jinxiao123580-hub/balance-car/hardware/pcb/README.md

# PCB资料状态说明

| 属性 | 内容 |
| --- | --- |
| 文档编号 | PH-PCB |
| 更新日期 | 2026-10-28，Asia/Shanghai；时分未记录 |

## 已有资料

v2026-09-23目录保留Board1与PCB1的.epro2包。两个源包分别保留，未因名称相近判定为重复。

## 待完成检查

库引用、板层、DRC、电源回流及生产导出未在本次归集验证。生产文件与BOM分别记录于相邻目录。
