jinxiao123580-hub/balance-car/hardware/schematic/README.md

# 原理图资料状态说明

| 属性 | 内容 |
| --- | --- |
| 文档编号 | PH-SCHEMATIC |
| 更新日期 | 2026-10-28，Asia/Shanghai；时分未记录 |

## 已有资料

v2026-09-23目录包含Schematic1的嘉立创.epro2源包，extracted保留原有解包文件及版本信息。源文件按原件校验。

## 待完成检查

尚未在EDA中核对符号、网络、库引用及导出PDF。当前源包不得等同于电气审查已经通过。
