jinxiao123580-hub/balance-car/mechanical/cad/README.md

# 机械设计源文件状态说明

| 属性 | 内容 |
| --- | --- |
| 文档编号 | PH-MECHANICAL-CAD |
| 更新日期 | 2026-10-28，Asia/Shanghai；时分未记录 |

## 已有资料

已归集STM32_Balance_V2.SLDASM、两份零件电机-主体连接.SLDPRT与载物台.SLDPRT。原件指纹校验通过。

上述原生CAD文件仅保留在本机。发布前需使用原软件检查内部作者、个人路径及其他元数据，本次由Git忽略；公开几何文件见[STL目录](../printable/)。

## 完整性限制

未使用SolidWorks打开验证外部引用，不能认定装配依赖完整。如存在缺件，需通过Pack and Go形成自包含包。STEP等通用格式尚未归集。
