jinxiao123580-hub/balance-car/docs/design/ros-layered-options-latex/README.md

# 平衡车 ROS 分层建设与成本选型研究

本文以论文式技术方案比较三个建设层次：保留现有 STM32、增加 ESP32、增加 Linux 车载板卡。包括摘要、需求与约束、架构设计、功能矩阵、预算、标定公式、实施验收和参考文献。费用为新增硬件预算估算，不是实时采购报价；内容不构成已完成的性能实验。

主文件：main.tex。

推荐使用 XeLaTeX，运行两遍以更新交叉引用和参考文献编号。使用 ctexart；当前 Windows 预览按相对路径加载 fonts/ 下的本机仿宋、黑体与楷体文件。字体仅供本机使用，已排除进入 Git；转移工程前应按目标环境重新配置合法可用的中文字体。项目可在 Codex 内置 LaTeX 编辑器中直接打开并预览 PDF。

工程位置：仓库内 `docs/design/ros-layered-options-latex/`。

对应总库入口与旧 PlatformIO 目录指向同一工程，不应再复制一份进行维护。

编译检查：2026-10-29，Codex 内置 LaTeX 编译器返回 success。正文为论文式方案分析，引用编号与表格、公式交叉引用已检查，预算分配合计2000元。首次运行可能需要初始化中文字体及TeX组件。
