jinxiao123580-hub/balance-car/docs/system-overview.md

# 系统设计说明

| 属性 | 内容 |
| --- | --- |
| 文档编号 | PH-SYSTEM-CURRENT |
| 更新日期 | 2026-10-28，Asia/Shanghai |
| 适用版本 | software/firmware中的当前归集版本 |

## 1. 系统组成

STM32F407ZG完成姿态处理、编码器采样和运动控制，BMI270提供惯性数据，步进驱动器接收STEP/DIR。电脑端通过BLE完成参数设置、曲线显示及CSV记录。

当前固件使用TMC_STANDALONE_STEP_DIR=1，不依赖UART寄存器配置才能启动。驱动电流、细分和斩波模式由实际载板硬件配置决定；两侧最终板件型号及拨码电平尚需在装配清单中统一确认。

## 2. 控制结构

```mermaid
flowchart LR
    ENC[编码器位置与速度] --> POS[位置P环]
    POS --> VREF[受限目标速度]
    ENC --> SPEED[速度PI环]
    VREF --> SPEED
    SPEED --> ANGLE[目标倾角修正]
    OFFSET[机械平衡角 O] --> TARGET[目标倾角]
    ANGLE --> TARGET
    IMU[BMI270姿态与角速度] --> PD[直立PD]
    TARGET --> PD
    PD --> DELTA[频率增量与限幅]
    DELTA --> INTEGRATE[积分生成STEP频率]
    INTEGRATE --> STEP[TIM2/TIM5边沿调度]
    STEP --> MOTOR[步进驱动与电机]
    MOTOR --> ENC
```

主循环设计周期2.5ms；速度及位置目标计算约100Hz。直立PD输出经R换算为频率增量，每10ms形成端点，再分成四个子步执行。L/S/B/H分别限制频率、常规增量和高速同向加速增量。

## 3. 引脚与接口

| 功能 | 引脚 | 当前软件实现 |
| --- | --- | --- |
| Motor1 STEP / DIR | PA6 / PA7 | TIM2中断调度PA6 GPIO，方向极性motor1Invert=false |
| Motor2 STEP / DIR | PA8 / PB0 | TIM5中断调度PA8 GPIO，方向极性motor2Invert=true |
| BMI270 SCL / SDA | PB8 / PB9 | I2C |
| 编码器1 A / B | PA0 / PA1 | 中断计数 |
| 编码器2 A / B | PB6 / PB7 | 中断计数及可信通道选路 |
| BLE串口 TX / RX | PB10 / PB11 | USART3 |

物理引脚不变，但STEP已不采用旧TIM3/TIM1 PWM机制。软件极性不替代对实际电机接线和轮向的确认。

## 4. 参数与位置原点

当前默认配置见[参数表](parameters.md)。位置环启用时捕获当时编码器位置，面板“当前位置设为回位点”重新指定原点。

位置与速度按可信编码器选路：双路平均或单路计数。位置采用增量累计，来源切换不引入累计位置跳变；点动时来源改变会取消任务。编码器分辨率、轮径和精确回原点仍待实测。前后遥控采用[固定倾角按住控制](turning.md)，相对O ±2°平滑建立和退出，期间暂停速度/驻车角度修正并清除速度I。回零后1秒渐入原速度环；驻车目标在整个移动、回零与恢复期间跟随当前位置，并清除旧的位置速度斜坡，恢复结束才锁定新驻车点，累计位置连续。此版尚未烧录实测。

## 5. 验证边界

当前源码独立编译、主机逻辑回归及面板离线界面检查通过；设计脉宽、实际ISR抖动、当前默认参数下的位置保持与所有工况稳定性尚无统一验证报告。历史试验不直接替代当前版本验证。
