jinxiao123580-hub/balance-car/history/reports/conflicts.md

# 技术勘误与遗留问题报告

| 属性 | 内容 |
| --- | --- |
| 报告编号 | PH-ISSUES-20261028 |
| 更新日期 | 2026-10-28，Asia/Shanghai；时分未记录 |
| 来源 | [证据索引](sources.md) |

历史误判与当前技术结论分列如下。争议事项未因报告规范化而视为解决。

| 编号 | 来源中的说法 | 合并后的处理 |
| --- | --- | --- |
| C01 | S2 写本车没有 A4988 / TMC 实机记录，S1 记录了这些阶段 | S2 的范围限于早期阶段记录，缺少记录不代表整个项目没使用。A4988 阶段先记为 S1 对 PPT 的转述；TMC 迁移由 S3/S5 补充。 |
| C02 | S1 称 10 月 MKS 出厂即 SC、无需焊接；S3 中现场称短接空焊盘，将 SPREAD 接 VIO，声音变大 | 两种历史叙述都保留。可能涉及不同板件、时间或识别错误，现有证据不能选定一个。不可写成所有 MKS V2.0 出厂默认 SC；不可据声音独立证明模式。 |
| C03 | S1 当前框图仍写 TIM3/PA6、TIM1/PA8 | 旧 PWM 阶段成立；S6 当前源码是 TIM2/TIM5 中断驱动 GPIO PA6/PA8。引脚相同不代表定时器或输出机制相同。 |
| C04 | S2 等记录把 CSV 中 m1Hz/m2Hz 非零说成定时器确实输出正确 STEP | CSV 证明软件命令非零；只有 GPIO 波形或回环计数能验证实际输出。无修复前后波形，不能把这一点写成实测事实。 |
| C05 | S4/S1 将三细分比较写成“已否证增量扭矩不足” | 比较中 O、K、L/S 和编码器状态同时变化，只能说明换细分没有在那些组合中消除现象。不能严格否证所有扭矩或衰减假设。历史锁定率未经本轮重算，不作标准化性能指标。 |
| C06 | S1 转述 A4988 “EN 拉低导致锁死”，并推断应把 EN 拉高使能 | A4988 ENABLE 低有效：高电平关闭输出，低电平允许输出；SLEEP 低电平休眠。抱持不转不等于 EN 低造成故障。不能按原推断接线。见下方厂商手册。 |
| C07 | 早期记录给出不同 VREF 换算，部分文字混淆公式与例子 | 本轮不沿用统一换算。驱动型号、采样电阻和电流定义必须先确定；BTT 的 rms_current(1200) 是配置请求，不是实测相电流。 |
| C08 | S1 一处写 TMC2208 无 UART | 不沿用该选型说法；是否有芯片接口和具体载板是否引出接口需分开核对，本项目无需靠该判断解释结果。 |
| C09 | S1 将 10 月后阶段写成缺少稳定运行记录 | S3 补有烧录成功、现场稳定反馈和 10-20 分段分析；可以描述这些观测，但仍没有统一条件的长期失步率、恢复时间和台架对照。 |
| C10 | S1 将 enc2 有计数进一步解释为接线故障被修好 | 有计数说明该时段通道有活动；不能证明根因、永久恢复或信号正确。没有已记录的维修动作。 |
| C11 | S1/S4 强调衰减模式；S3 强调 STEP 调度与换向、阻塞修复 | 分别是阶段性假设和软件发现。模式、代码、限幅和硬件都发生过变化，不能把成功单独归到 SC 或单个软件缺陷。 |
| C12 | S1 从 PPT 文件时间推断 A4988→DRV8825 发生在 8 月 16～17 日 | 文件修改时间不能保证内容反映当日硬件。该窗口仅作原作者推断保留，合并时间线将确切更换时间标为未知。 |
| C13 | S1/S3 或注释混写“位置环 400Hz” | 当前位置测量在主循环约 400Hz 更新；位置 P 生成目标速度是在 updateOuterLoop 中约 100Hz。应区分测量周期和控制计算周期。 |
| C14 | S3 指出单编码器位置尺度问题，并提出修复 | 这是发现和建议，尚未完成该项修复。S6 位置仍固定平均两路累计计数，速度则按信任门选路。不能把“计划修正”写成“已修正”。 |
| C15 | 早期叙述说“角度误差直接给 STEP 只适用于直流电机” | 这是当时的设计讨论，不是普遍定理。STEP 频率对应速度，直流电机通常用 PWM/电流指令；本车改用 PD→速度增量→积分频率结构。不能仅凭此判定所有直接速度控制结构无效。 |
| C16 | 部分阶段报告把 OpenOCD stderr / exit 1 统一视作烧录成功 | 只按当次 Programming、Verified OK、Resetting 等明确输出判断，不能忽略真正的 init/open failed 或校验失败。 |

## 模式、电平与引脚判定

TMC2209 独立模式可由 SPREAD 配置斩波方式；寄存器配置还需考虑 GCONF、OTP 等状态。对 VIO=3.3V 的具体模块，先确认目标网络和允许电平，不能仅凭 R9 字样、空焊盘或旧标注图就指导短接。S1/S3 中对焊盘、芯片脚号、+5V/VIO 的说法不一致，本整理不发布焊接操作图。

S3 中曾有 未经实物核验的焊盘标注被撤回，不作为接线依据。现场“已将 SPREAD 接到 VIO”的反馈可归档，但未补测量照片或寄存器读回。

## 参考依据

- [Allegro A4988 数据手册（Pololu 托管），Enable Input / Sleep Mode，印刷页 10](https://www.pololu.com/file/0J450/A4988.pdf)：ENABLE 高关闭、低允许输出；SLEEP 低休眠。
- [ADI TMC2209 数据手册 Rev.1.09](https://www.analog.com/media/en/technical-documentation/data-sheets/TMC2209_datasheet_rev1.09.pdf)：核对 SPREAD、VCC_IO 与 GCONF；厂商芯片资料不能单独证明手中载板的焊接状态。
- [MKS 官方 V2.0 原理图](https://github.com/makerbase-mks/MKS-StepStick-Driver/blob/master/MKS%20TMC2209/MKS%20TMC2209%20V2.0_001/MKS%20TMC2209%20V2.0_001%20SCH.pdf)：载板连接参考，需和实物核对。

以上资料用于纠正一般电气逻辑，不替代本车测试。原始观点可由中转区备份追溯；正式结论采用本页及阶段报告的限定口径。
