jinxiao123580-hub/balance-car/history/reports/sources.md

# 证据与资料索引

| 属性 | 内容 |
| --- | --- |
| 文档编号 | PH-EVIDENCE-20261028 |
| 更新日期 | 2026-10-28，Asia/Shanghai；时分未记录 |
| 覆盖范围 | 工程源文件、阶段报告、实验数据与硬件资料 |
| 状态 | 已归集主要项目文件；部分测量与原始版本记录缺失 |

## 1. 来源编号

| 编号 | 资料 | 时间范围与适用边界 |
| --- | --- | --- |
| S1 | [开发阶段总结](records/report_development_20260520_20261024.md) | 汇报前史至2026-10-24；部分事件由文件时间或后期记录重建 |
| S2 | [控制与遥测联调报告](records/report_control_20260917_20260918.md) | 主要为2026-09-17～18；未覆盖后续硬件不代表项目未采用 |
| S3 | [驱动集成与验证进展报告](records/report_integration_20260928_20261028.md) | 2026-09-28～10-28；实施、烧录及实机反馈分别记录 |
| S4 | [换向异常阶段试验报告](records/report_reversal_20260923.md) | 截至2026-09-23 20:44；多变量试验不是唯一根因证明 |
| S5 | [混配驱动阶段验证报告](records/report_hybrid_20260928.md) | 截至2026-09-28 19:25；UART配置状态未读回 |
| S6 | [主固件](../../software/firmware/src/main.cpp)、[构建配置](../../software/firmware/platformio.ini) | 归集版本；新路径构建及主机回归通过，不代表所有工况实机验证 |
| S7 | [蓝牙面板](../../software/ble-panel/ble_tune_panel.py) | 默认22项与固件匹配；路径和本机设备地址配置已适配 |

S1～S5为规范化报告。改写前文本及初始来源原件保存在仓库外中转区，原件指纹用于追溯。当前报告不冒充未经编辑的原始实验转储。

## 2. 原始来源指纹

| 来源 | 原件SHA-256 |
| --- | --- |
| S1 | B67D247555B5D59C8087419D47E7CDABA4F3C69212C3829FC85396E95BCA6D3C |
| S2 | 790A30408AFC9967DBA137BB1D214066B34E4FD7352A60D1D3B7330C8160B219 |
| S4 | 10E0C06B553E8ED2121E56D124CAD92389389999A728C11C4DF0E66E347F7847 |
| S5 | 8941DCC59E673025D8CE9FCBB16FC89F8EB7A54C978620962607403AC39B76B7 |
| S6主程序 | 7D155CB84F41D116D17F3692096D2B28EC13DE413B4093BB4CB900DBE99AA22B |
| S7迁移前面板 | 825EED78BC7673F46502F4BC0AC83F40D4C445596CD011653F41897EC8C690BC |

指纹不证明内容正确，也不等于规范化副本的当前指纹。面板迁移后已调整数据路径和设备地址读取方式。

## 3. 实验数据

94份日期命名调参CSV及其他诊断数据位于[raw目录](../data/raw/)。日期来自文件名，ms表示MCU上电时间；参数标签由面板写入，需与设备回显及下发记录核对。

| 文件 | 用途 | 分析状态 |
| --- | --- | --- |
| ble_tune_log_20260917_165009_185_p11420.csv | 高频命令与反馈不一致 | 有历史分析；尚无同步STEP波形 |
| ble_tune_log_20260917_171045_688_p11420.csv | 失败录制 | 仅重连标记，不作运动证据 |
| ble_tune_log_20260917_203534_858_p11420.csv | 失败录制 | 仅表头，不作运动证据 |
| ble_tune_log_20260923_195736_949_p17656.csv | 换向相关异常 | 历史统计待统一算法复核 |
| ble_tune_log_20260923_203020_049_p24520.csv | 1/8试验组合 | 多变量条件，不作单因素比较 |
| ble_tune_log_20260928_173505_691_p32248.csv | 混配阶段 | SC未读回 |
| ble_tune_log_20261015_204349_410_p32652.csv | 不跟随片段 | 已有分段分析，无物理输出测量 |
| ble_tune_log_20261020_095502_292_p23136.csv | 未干预末四分钟 | 已有姿态与漂移统计 |
| ble_tune_log_20261020_104252_893_p44156.csv | 位置环开启后的末四分钟 | 已有目标速度与回位分析 |
| ble_tune_log_20261022_212411_029_p28960.csv | 后期长记录、编码器2活动 | 已归集，未重新统计锁定率 |
| ble_tune_log_20261024_200643_992_p29636.csv | 后期长记录和O调整 | 已归集，未重新统计锁定率 |

m1Hz/m2Hz为软件命令，不是频率计或示波器实测结果。失败录制、人工操作区间与自主运行区间分别判定。

## 4. 硬件与机械资料

| 资料 | 仓库位置 | 当前核验状态 |
| --- | --- | --- |
| Board1、PCB1的.epro2源包 | hardware/pcb/v2026-09-23/ | 原件指纹校验；尚未完成EDA规则及库检查 |
| Schematic1的.epro2及已有解包内容 | hardware/schematic/ | 同上 |
| STM32_Balance_V2.SLDASM及两份.SLDPRT | mechanical/cad/ | 原件校验；装配外部引用待核对 |
| 两份STL | mechanical/printable/ | 原件校验；打印参数待补充 |
| VID_20260811_103124.mp4 | history/media/video/ | 已归集；不由文件名推导当前版本性能 |
| 平衡车系统汇报.pptx | history/presentations/ | 早期项目资料；未逐页完成公开审查 |
| 多项目组会汇报相关页 | 外部共享资料，未整份纳入仓库 | 历史报告引用第183～186页，未重新解析 |
| 厂商PDF | docs/references/vendor/，默认不入Git | 官方链接见参考资料目录，需和实物核对 |

## 5. 缺失证据与补充计划

- 修复前后STEP/DIR及相电流波形，ISR延迟和抖动。
- 相同硬件、参数与动作下的SC/stealthChop及输出机制单变量对照。
- 两轮载板标识、限流、细分、供电及焊位的统一登记。
- TMC成功读回帧，编码器2维修与持续可靠性记录。
- 位置尺度修正、原点保持与速度积分整定结果。
- 每次实施时间、代码版本及烧录记录的完整对应关系。

资料缺口作为项目状态的一部分保留，不以推断补齐。
