jinxiao123580-hub/balance-car/history/reports/records/report_integration_20260928_20261028.md

# 驱动集成与验证进展报告

| 属性 | 内容 |
| --- | --- |
| 报告编号 | PH-INTEGRATION-20261028 |
| 事件范围 | 2026-09-28～2026-10-28；部分事项只保留相对顺序 |
| 编制日期 | 2026-10-28，Asia/Shanghai；时分未记录 |
| 依据 | 操作记录、实机反馈、代码、构建/烧录输出及已有CSV分析 |
| 结论口径 | 实施、主机验证和实机观测分别陈述 |

## [9 月 28 日阶段及之后，部分事件日期未知] UART、载板和电平排查

- 现场反馈 TMC UART 连续失败；不同阶段日志有 rx=0、PA9 低电平、接入后约 1.06V、断开后 3.3V。
- 现场报告早期开发板稳压部分损坏、更换板子；后续给出 VIO≈3.3V、VM≈11～12V 的测量。不同测量属于不同硬件状态，不能当成一个连续恒定条件。
- 写入专用固件出现 bytes=192、PA9≈3.28V，只能确认发送路径和直流电平，不能确认 TMC 收到帧或寄存器生效。
- 读回测试仍出现 address=-1、rx=0；没有 version、IFCNT、GCONF 的成功读回。
- 单向转问题经现场重新交换测试，故障随某块 TMC 载板迁移；与 S5 阶段记录一致。不能从 UART 失败单独推断相同故障。

## [MKS 阶段，具体日期未完全定位] 硬件配置 spreadCycle

- 现场说明将 MKS 空焊盘短接，使 SPREAD 接到 VIO；改完声音变大。
- 现场随后仍报告锁死，要求检查软件。
- S1 另有“出厂即 SC、无需改焊”的描述，二者尚未消解；两类记录均不推广至所有同型号板件。
- 独立 STEP/DIR 固件不通过 UART 请求模式。现场反馈与配置条件支持硬件模式选择的判断，但没有寄存器或电流波形证据。

## [2026-10-14～15 阶段；精确时刻未知] STEP/DIR 与方向配置

- 主固件设置 TMC_STANDALONE_STEP_DIR=1，跳过 UART 初始化阻塞和读回流程；继续由 STEP/DIR 控制电机。
- 工程记录报告只翻转后轮 motor2Invert，保持 speedLoopDirection=-1；归集版本源码为 motor1Invert=false、motor2Invert=true。
- 现场之后仍反馈方向反了，不能仅凭代码或烧录成功判定物理方向已完全验证。后来稳定运行反馈是后续组合状态，不用于补写当时的单独测试结果。

## [2026-10-15] 锁死日志与软件审查

- 证据文件：ble_tune_log_20261015_204349_410_p32652.csv。
- 已有分段分析记录在 MCU 129.189～129.939s，命令由 1210Hz 升到 3500Hz，enc1 保持 -3039；约 130.189s enc1 再变化。
- 这支持“命令与编码器运动不一致”，不证明实际 STEP 波形，也不排除编码器漏计。
- 代码审查发现：正→0→负可漏判换向；长参数回显直接串口打印可能阻塞；固定时间基准在长延迟后会补跑积分；旧 PWM 运行时参数预装载可能造成低频更新滞后；停机/零指令行为不明确。
- 其中低频预装载与故障之间没有波形对照，仅为代码机制上的嫌疑，不能写成已实测根因。

## [2026-10-15] 实施修复，编译及主机回归

- STEP 改用 TIM2/TIM5 的定时器中断调度 PA6/PA8 GPIO 边沿；固定高脉宽设计为 4µs，保持 DIR 建立间隔。硬件实际脉宽仍待测。
- 保留最后非零方向，在 2.5ms 子周期预测跨零并应用软保护；清除控制状态时重置换向状态。
- 零指令停止发步并拉低 STEP；非法命令停止该路。
- 蓝牙回复用 QueuedBtReply 入队，控制超时重同步，不集中补跑；增加边沿计数和耗时诊断。
- 验证记录编译成功；test/run_motion_regressions.py 的主机模拟检查通过。主机寄存器模拟不覆盖真实 ISR 延迟、并发与物理输出波形。
- 阶段记录明确“暂未烧录”；不能把编译日期当作首次运行日期。

## [2026-10-20] 修复版烧录及现场稳定反馈

- 验证输出包含 Programming Finished、Verified OK、Resetting Target、SUCCESS。
- 现场随后反馈稳定、仍有少量漂移、离开原位后回不去。
- 同时较早失败组合与此时参数不同，例如 S=400→100、L=3500→1750。模式、参数和代码共同变化，未完成单变量归因。

## [2026-10-20，09:55 录制] 无人干涉最后四分钟，位置环关闭

- 文件：ble_tune_log_20261020_095502_292_p23136.csv。
- 按现场澄清，只评估 MCU 149.623～389.623s，961 条记录。此前 O 调整为人工调参，不当作异常跳变。
- 固定参数包括 P=1000、D=100、O=10、K=-0.02、I=0、X=0、Y=0。
- 已有分段分析：平均 pitch≈9.968°，956/961（约99.5%）采样在9～11°；fallStopCount未增加。该采样比例不等于全带宽姿态误差或长期可靠性。
- 位置显示从-2627.5到-1800；回位目标速度全程0。不能期待关闭的位置环返回原点。
- 速度按可信编码器选路，位置仍固定平均两路；enc2接近不变时位置尺度约减半。发现了该问题，但未实施修复。

## [2026-10-20，10:42 录制] 位置环开启，但仍漂移

- 文件：ble_tune_log_20261020_104252_893_p44156.csv。
- 最后四分钟 MCU 164.333～404.333s，961条；O=12、K=-0.02、I=0、X=0.5、Y=1、M=30。
- 已有分段分析：pitch范围11.19～12.63°，位置从-8到-118；866/961（约90%）样本的回位目标速度已到+1；修正角未撞到N=2°。
- 判断：位置环已发回位要求，不能再说“未开启”。仅增大X在输出已受Y限制时不会增加最大回位要求。速度跟踪、符号和慢偏置仍需验证。
- 曾提出K=-0.05评估方案，但尚未取得该方案的实测确认；不作为稳定基线。
- I=0关闭速度积分。J=2、Y=1时，静止附近小回位速度误差可能达不到积分门槛；不是已实施的新积分策略。

## [2026-10-22] 现场指定截图参数，设为固件默认并烧录

```text
P=1000 D=100 O=4 Z=0
L=1750 S=100 B=1000 H=40 R=0.1
K=-0.02 I=0 N=2 W=50 J=2 E=0
X=5 Y=1 M=0 F=5 G=10 T=0 U=0
```

- 实际修改默认值O、X、Y、M及初始targetBalanceAngle，其余匹配截图。
- 验证输出Programming Finished、Verified OK、Resetting Target、SUCCESS。烧录成功不自动证明这组参数可精确回原点。
- 独立位置I方案仅讨论过，没有实现；速度环仍通过目标角修正进入直立环。

## [2026-10-23] 蓝牙面板默认值同步

- 面板PARAMS修改O=4、X=5、Y=1、M=0。
- 对22项默认参数做AST/语法检查并与固件声明比对，通过。
- 已打开面板需重启载入新默认；默认值、待发输入和车端实际状态仍需区分。

## [2026-10-27] 展示目录建立

- 建立hardware、software、mechanical、docs分类和README、.gitignore。
- 当时未复制整套固件、硬件文件，也未创建或上传GitHub仓库。
- 阶段分析认为软件修复、SC配置与较温和参数共同伴随改善；缺少单变量对照，不作单一根因判定。

## [2026-10-28] 本次合并

- 完成阶段资料S1/S2/S4/S5核对，确认当前TIM2/TIM5输出实现及默认参数，并清点94份CSV及硬件材料。
- 完成工程归集、新路径编译、主机回归及面板界面检查；未重新烧录或永久删除。
- 本报告为阶段资料汇编，不替代原始波形、逐次代码版本和设备配置确认。来源及技术勘误分别见[证据索引](../sources.md)和[技术勘误](../conflicts.md)。
