jinxiao123580-hub/balance-car/docs/publishing.md

# 公开发布范围

日期：2026-10-28，Asia/Shanghai。

本次公开固件、面板、分析工具、原理图与PCB源包、STL、规范化技术报告和历史调参数据。已对候选文件名、文本及EDA源包内文本进行个人路径、邮箱、设备地址、手机号和常见凭据模式检查；数值匹配已核对为工程坐标、标识或文件指纹。

以下资料保留在本机，不进入提交：

- Python环境、构建缓存、编辑器状态和本机设备配置。
- 离线厂商PDF及仓库外的迁移备份、审查记录。
- 旧汇报PPT：尚未逐页审查公开内容。
- 早期视频：含拍摄设备信息，画面与音轨尚未逐段审查。
- SolidWorks原生源文件：内部元数据尚未通过原软件核验；先提供STL。

提交使用GitHub用户名与noreply邮箱。扫描不等同于专用软件的完整元数据检查；未完成审查的原生文件不以扫描无命中作为公开依据。
