jinxiao123580-hub/balance-car/history/reports/README.md

# 开发记录与阶段报告索引

| 属性 | 内容 |
| --- | --- |
| 文档编号 | PH-INDEX-20261028 |
| 更新日期 | 2026-10-28，Asia/Shanghai |
| 内容范围 | 历史阶段报告、开发时间线、证据及技术勘误 |
| 记录原则 | 已完成、已验证、待验证分别记录；缺失时间不补写 |

## 综合报告

- [项目进展报告](project-progress-through-20261028.md)
- [开发时间线](timeline.md)
- [换向与漂移分析报告](analysis.md)
- [技术勘误与问题清单](conflicts.md)
- [证据与资料索引](sources.md)

## 阶段报告

| 报告 | 事件覆盖 | 文档性质 |
| --- | --- | --- |
| [项目开发阶段总结](records/report_development_20260520_20261024.md) | 2026-05-20 文件记录至 2026-10-24 | 多阶段汇总，时间可靠性分别标注 |
| [控制与遥测联调报告](records/report_control_20260917_20260918.md) | 2026-09-17～18，含早期背景 | 控制结构、数据链路和遗留问题 |
| [驱动集成与验证进展报告](records/report_integration_20260928_20261028.md) | 2026-09-28～10-28 | 模式、软件修复、稳定观测和归集 |
| [换向异常阶段试验报告](records/report_reversal_20260923.md) | 截至 2026-09-23 20:44 | 试验组合与驱动方案评估 |
| [混配驱动阶段验证报告](records/report_hybrid_20260928.md) | 截至 2026-09-28 19:25 | 载板异常、混配和UART配置状态 |

## 记录格式

后续条目采用：事件时间及依据、阶段目标、实施内容、试验条件、验证结果、限制、后续计划。CSV文件名时间用于标识录制起点，ms列表示MCU运行时间；文件修改时间不直接作为实验发生时间。

原始工作记录与改写前文档保存在仓库外的中转区。当前records目录存放规范化报告，不是未经编辑的原始转储。文本规范化不代表新增实机验证。
