jinxiao123580-hub/balance-car/mechanical/drawings/README.md

# 机械加工图编制状态

| 属性 | 内容 |
| --- | --- |
| 文档编号 | PH-MECHANICAL-DRAWING |
| 更新日期 | 2026-10-28，Asia/Shanghai；时分未记录 |

## 当前状态

尚未归集定版加工图。零件源文件和STL不能替代带尺寸、公差、材料及版本的加工图。

## 完成要求

加工图与对应CAD版本绑定，记录单位、材料、关键尺寸、公差和装配要求。
