jinxiao123580-hub/balance-car/docs/demo/README.md

# 当前版本演示资料

更新日期：2026-10-28，Asia/Shanghai。

当前版本尚未归集可明确对应默认参数、硬件配置及测试条件的实车演示。当前面板离线界面已存于docs/images。

早期视频已归入history/media/video，不用其文件名日期或画面证明当前版本性能。新演示应记录固件版本、驱动配置、供电及试验动作。
