jinxiao123580-hub/balance-car/docs/images/README.md

# 项目图像资料状态

| 属性 | 内容 |
| --- | --- |
| 文档编号 | PH-IMAGES |
| 更新日期 | 2026-10-28，Asia/Shanghai；时分未记录 |

## 当前状态

已收录当前调参面板的[离线界面截图](ble-panel-offline.png)，展示当前默认参数与界面布局，不代表实车采集波形。

当前版本的整车、接线和装配图片尚待补充。早期视频见[历史影像目录](../../history/media/video/)，不作为当前版本效果展示。

## 记录要求

后续图片标明拍摄日期、硬件版本及展示内容，并检查个人信息。接线说明以实物与源工程核对，不使用未经核验的标注作为操作依据。
