jinxiao123580-hub/balance-car/history/reports/analysis.md

# 换向异常与位置漂移分析报告

| 属性 | 内容 |
| --- | --- |
| 报告编号 | PH-ANALYSIS-20261028 |
| 编制日期 | 2026-10-28，Asia/Shanghai；时分未记录 |
| 事件范围 | 9月换向异常至10月稳定性与位置保持试验 |
| 依据 | [证据索引](sources.md)、[开发时间线](timeline.md) |

## 问题与系统

项目采用STM32F407ZG、BMI270、编码器和STEP/DIR步进驱动，使用PlatformIO及Arduino framework。驱动经历DRV8825、BTT TMC2209、MKS TMC2209等阶段；中间也有前DRV/后TMC混配，不能把所有日志当作同一套硬件。

核心现象是换向或加减速时轮端短暂停止跟随，而软件仍提交非零频率命令；随后可能恢复，也可能导致车身倾角增大。后期获得直立稳定的现场反馈后，主要剩余问题转为位置漂移与回原点能力。

## 排查一：把电气故障、指令输出和机械运动分开

通过串口接收统计、电平测量和载板交换进行排查。一块BTT载板在现场重新交换后表现为“装在哪侧，哪侧不能换向”；载板拔下时MCU DIR电平恢复正常。这支持故障跟随载板，而不是直接归罪于后轮GPIO。具体损坏机理未做内部或阻抗确认。[S1/S5](sources.md)

UART曾出现接入后低电平、读回无数据。write-only发送计数增加只证明主控发过数据，不证明TMC收到或模式配置成功。后续改独立STEP/DIR绕过UART初始化等待；硬件选择斩波模式。MKS出厂模式与改焊过程的来源有冲突，不发布未经核对的焊接图。[C02/C04](conflicts.md)

## 排查二：控制斜坡必须落实到实际脉冲

在频率积分控制结构下，已设置L/S/B/H限幅，并把每10ms的频率增量分成四个2.5ms子步。早期加保护和平滑后仍出现卡顿，说明仅有软件命令斜坡并不能保证实际轮端运动。[S2](sources.md)

后续代码审查识别并修改以下机制：

| 发现 | 修改 | 验证范围 |
| --- | --- | --- |
| 正→0→负可能漏掉方向变化，保护也可能晚于跨零 | 保留最后非零方向，在子周期预测跨零并立即应用软保护 | 编译、提取生产代码的主机模拟；实机贡献未单独量化 |
| 低频PWM预装载存在等旧周期才更新的风险 | TIM2/TIM5中断调度GPIO边沿，在低相位调整下一步等待 | 逻辑与编译检查通过，未取得修复前后示波器波形 |
| 零命令继续短暂保持旧频率、停机电平不明确 | 零命令停止发步、STEP拉低，设计固定高脉宽与DIR间隔 | 主机模拟通过；中断延迟及物理脉宽待测 |
| 蓝牙长回显阻塞控制、超时后集中补跑积分 | 回复入队按预算发送，严重迟到后重同步并重置输出状态 | 编译及代码检查；新增超时/边沿诊断，需现场记录 |

软件修复在10月15日编译和主机回归通过，10月20日烧录日志显示编程、校验与复位完成。现场随后反馈直立稳定。验证限制：硬件模式、板件、参数也变化过，因此不是单变量实验。[后期记录](records/report_integration_20260928_20261028.md)

## 阶段结果：稳定直立不等于位置保持

10月20日09:55录制的现场指定末四分钟（MCU149.623～389.623s）有961条记录。已有分段统计平均pitch约9.968°、约99.5%的采样处于9～11°，倒地保护计数不增加。它支持该段姿态稳定，但不代表已验证长期零失步或所有场景稳定。[分析来源S3与CSV清单](sources.md)

该段X=0、Y=0，回位目标速度为0。位置从-2627.5变为-1800的计数单位；位置环没有要求回到原点，所以不能把停在偏移位置视为位置控制失效。此前的O突变属于人工调参，已按现场澄清从无人干涉评估中剔除。

后续10:42录制末四分钟，X=0.5、Y=1、M=30，回位要求约90%的采样到达Y上限，但位置仍偏移，姿态11.19～12.63°。这次位置环确实开启，问题转为小回位速度跟踪、尺度和反馈验证，不能再用“加大位置P”一项概括解决。[S3](sources.md)

检查还发现位置固定平均两路计数，而速度可切到单路可信编码器；enc2不活动时两个量的尺度不一致。该项已识别但未修复。X从0开启会捕获当时原点；位置I仅讨论过，未实施。I=0时速度积分关闭；J与Y的组合也会影响小误差积分启用。

## 版本与参数边界

10月22日按现场截图固化并烧录，10月23日同步蓝牙面板默认：

```text
P=1000 D=100 O=4 Z=0
L=1750 S=100 B=1000 H=40 R=0.1
K=-0.02 I=0 N=2 W=50 J=2 E=0
X=5 Y=1 M=0 F=5 G=10 T=0 U=0
```

这是默认配置及烧录记录，不是上面O=10或O=12稳定数据的同一组参数；不能把所有性能数字冠到本配置上。后期CSV还存在面板O调到6的记录，与上电默认4并不矛盾。K=-0.05只是曾提出的建议，未确认为已验证基线。

## 验证结论与未完成事项

已完成：多阶段载板排查、频率增量积分和限幅、STEP边沿调度、过零保护修复、非阻塞蓝牙、参数/CSV链路，以及特定时段的稳定直立观测。对应证据的强度各不相同，代码实现、编译、烧录和实机观测分别陈述。

尚未完成验证的目标包括：SC或某一软件修改单独解决失步、永久零锁定、所有工况稳定、精确原点保持、编码器故障永久根治。进一步测试应固定硬件与参数，记录实际STEP/DIR、供电、限流与编码器，区分模式和软件的贡献。

工程结论：不能把“发出了命令”当成“输出波形正确”，不能把“编译或烧录通过”当成“实机验证完成”，也不能用不同硬件和参数的前后反馈得出单一根因。
