jinxiao123580-hub/balance-car/history/reports/project-progress-through-20261028.md

# 步进平衡车项目进展报告

| 文档属性 | 内容 |
| --- | --- |
| 报告编号 | PH-PROGRESS-20261028 |
| 版本 | V1.0 |
| 编制日期 | 2026-10-28，Asia/Shanghai；编制时分未记录 |
| 覆盖范围 | 2026 年 5 月文件记录至 2026-10-28 工程归集 |
| 报告对象 | 嵌入式控制、硬件设计与实验验证 |
| 数据口径 | 事件时间、资料修改时间、录制起点、MCU 上电时间分别标注 |

## 1. 项目目标

实现基于步进电机的直立控制，处理换向不跟随问题，并建立速度及位置反馈、参数调试、数据记录和工程归档链路。当前阶段目标由直立稳定逐步转向位置保持与可重复验证。

## 2. 系统组成

| 子系统 | 已有实现或资料 | 当前限制 |
| --- | --- | --- |
| 控制器 | STM32F407ZG，PlatformIO black_f407zg，Arduino framework | 实际周期和中断抖动尚无完整波形记录 |
| 姿态 | BMI270，安装轴向适配及姿态滤波 | 早期 MPU6050 迁移的逐次标定记录不完整 |
| 执行机构 | STEP/DIR；DRV8825、BTT/MKS TMC2209 等阶段 | 最终板件标识、限流和细分需统一登记 |
| 输出调度 | TIM2/TIM5 中断驱动 PA6/PA8 STEP；DIR 为 PA7/PB0 | 设计脉宽与实际波形需分别验证 |
| 反馈 | 双编码器计数及可信通道选路 | 编码器 2 曾间歇失效；位置尺度修正尚未实施 |
| 调参记录 | 蓝牙面板、CSV 与分析脚本 | 参数标签需与设备回显核对 |
| 结构与电路 | 3 份 EDA 包、装配体、零件及 STL | EDA 完整性及 CAD 外部引用待专用软件复核 |

## 3. 阶段进展

| 事件时间及依据 | 阶段进展 | 验证状态 |
| --- | --- | --- |
| 2026-05-20，汇报文件时间 | 直流减速电机方案资料形成 | 仅有文档依据，非精确实验日期 |
| 不晚于 2026-08-16，历史汇报记录 | A4988 步进阶段，记录振动、供电及使能问题；采用细分与结构垫片等措施 | 供电、主控及实测数据缺失，部分早期解释已勘误 |
| 2026-08-17，联调记录日期 | 建立蓝牙接收、绘图与 CSV 工具 | 当时实机联调未闭环 |
| 2026-09-01，变更记录时间 | 试验直立输出缩放及速度直接叠加 | 编译通过；烧录 open failed，效果未验证 |
| 2026-09-17～18，阶段记录 | 高速加速保护、四子步平滑、速度环目标角结构及遥测适配 | 最终烧录校验通过；仍有卡顿反馈 |
| 2026-09-23 20:44，阶段记录 | 汇总多种细分及换向试验，评估驱动器方案 | 多变量试验，未确认唯一根因 |
| 2026-09-28 16:24～17:17，操作记录 | 载板交换使单向故障随某块 TMC 迁移 | 定位到载板级，具体内部缺陷未测 |
| 2026-09-28 19:25，阶段记录 | 前 DRV/后 TMC 混配，UART write-only，读回仍待解决 | MCU 烧录与驱动寄存器配置分开判断 |
| 2026-10-15，实施记录日期 | 修复换向漏判、STEP 调度、串口阻塞和超时补跑机制 | 编译与主机回归通过，当时尚未烧录 |
| 2026-10-20，烧录记录日期 | 修复版写入并校验，进入稳定直立与漂移测试 | 取得实机稳定反馈及分段数据 |
| 2026-10-22，配置与烧录记录 | 默认参数更新为 O=4、X=5、Y=1、M=0 | 编程、校验和复位完成，回位效果另行验证 |
| 2026-10-23，工具验证记录 | 面板 22 项默认同步 | 语法及参数一致性检查通过 |
| 2026-10-28，归集记录日期 | 完成工程、数据、硬件和结构资料归集 | 211 个原位置文件校验；未永久删除、未重新烧录 |

精确时刻缺失的阶段只保留日期。完整事件及证据对应关系见[开发时间线](timeline.md)。

## 4. 关键技术工作

### 4.1 换向不跟随问题

通过指令、编码器、电平与载板交换分离软件和电气现象。CSV 中非零命令不能证明实际 STEP 波形正确；载板交换反馈支持存在独立硬件异常。

代码审查识别了跨零方向记忆丢失、保护滞后、低频 PWM 更新延迟风险、串口长回复阻塞以及迟到周期集中补跑等问题。后续改用按边沿调度的 STEP 输出并调整保护与发送机制。

### 4.2 稳定性与位置保持

速度环通过修正目标倾角参与直立控制；位置 P 先生成受限目标速度。速度积分只积分速度误差，不能替代位置反馈。

X/Y 为零时没有回原点要求。位置环开启后，仍需检查目标速度跟踪、积分门槛、原点捕获及编码器量纲。位置计算固定平均双路、速度按可信通道选路的不一致已经识别，但尚未修正。

### 4.3 可复现工程与记录

当前固件、面板、分析工具及原始数据集中存放。资料包含失败录制与历史备份，不将文件存在、编译通过、烧录通过和实机成功合并表述。

## 5. 已有量化观测

| 记录区间 | 条件 | 观测 | 适用范围 |
| --- | --- | --- | --- |
| 2026-10-20 09:55 录制，MCU 149.623～389.623 s | O=10、K=-0.02、I=0、X=0、Y=0；人工操作排除后的末四分钟 | 961 条；平均倾角约 9.968°，956/961 条在 9～11°；位置计数 -2627.5→-1800 | 支持该时段姿态稳定，不证明零漂移或长期零失步 |
| 2026-10-20 10:42 录制，MCU 164.333～404.333 s | O=12、X=0.5、Y=1、M=30、K=-0.02、I=0 | 961 条；倾角 11.19～12.63°；位置 -8→-118；866/961 条回位要求达到 Y 限幅 | 位置环已动作，但回位性能未达成 |

以上沿用已有分段统计，本次文档规范化未重算全部 CSV；角度采样比例不是连续时间误差上界。配置条件与当前 O=4 默认不同，不跨版本复用指标。

## 6. 当前配置与工程验证

```text
P=1000 D=100 O=4 Z=0
L=1750 S=100 B=1000 H=40 R=0.1
K=-0.02 I=0 N=2 W=50 J=2 E=0
X=5 Y=1 M=0 F=5 G=10 T=0 U=0
```

2026-10-28 新路径独立构建成功，RAM 7904 B、Flash 77400 B；主机运动回归通过。面板依赖导入、界面构造及参数核对通过，验证时未连接蓝牙或运行实车。

## 7. 风险与后续计划

| 优先级 | 工作项 | 完成判据 |
| --- | --- | --- |
| 高 | 核对位置与速度编码器尺度 | 单路/双路情况下量纲连续；原点捕获与回位方向经实测确认 |
| 高 | 记录实际输出与驱动状态 | 同步 STEP/DIR、编码器、供电与限流，明确软件命令和物理输出差异 |
| 高 | 固定条件比较模式与软件机制 | 相同硬件和参数下重复试验，不同时改变多个关键变量 |
| 中 | 硬件、机械完整性检查 | EDA 库引用及规则检查；SolidWorks 无缺件 |
| 中 | 完善发布资料 | 当前版本演示、BOM、引脚表、许可与数据来源齐全 |

现有证据支持阶段性改善，尚不支持“单一根因已完全证明”“精确原点保持已完成”或“所有工况零失步”等结论。
