jinxiao123580-hub/balance-car/history/reports/timeline.md

# 项目开发进度时间线

| 属性 | 内容 |
| --- | --- |
| 记录编号 | PH-TIMELINE-20261028 |
| 更新日期 | 2026-10-28，Asia/Shanghai；时分未记录 |
| 依据 | 来源编号见[sources.md](sources.md)，技术勘误见[conflicts.md](conflicts.md) |

时间口径：操作记录时间、文件时间、录制开始时间、MCU运行时间分开使用。S1的归档操作记录时间本轮没有重新解码验证；未知事件不强行插入具体日期。

## 按时间排列的事件

| 时间与依据 | 事件、动作与结果 | 证据和边界 |
| --- | --- | --- |
| 2026-05-20，S1引述PPT文件时间 | 直流方案前史：购买车、减速电机及驱动选型 | S1；PPT本轮仅确认存在，未重新解析。文件时间不是实验日期。 |
| 不晚于2026-08-16，S1对汇报的归档判断 | 42步进+A4988；记录全步振动、烧板、抱持不转等问题；记载改1/8和加电容 | S1；缺原代码/CSV，主控与实际接线待确认，EN解释有误见C06。 |
| 更换日期未知，先于后续DRV阶段 | A4988转DRV8825，可能伴随主控与机械迭代 | S1；不能只凭PPT修改时间断定发生在两天之间，见C12。 |
| 2026-08-17，S1引述联调文档 | 蓝牙遥测脚本准备，早期UART5方案与波特率调整 | S1；工具就绪不等于当日实机链路通过，后期改USART3。 |
| 日期未知，9月中旬以前 | MPU6050转BMI270；安装轴/符号适配；多种控制算法探索后进入步进频率积分主链 | S2；不能恢复各次修改的精确时间和完整效果。 |
| 2026-09-01，变更日志文件时间 | 直立输出缩放0.7、直接速度叠加实验；编译通过，烧录open failed | S1；未证明该版本实际运行。R命令后期含义也发生变化。 |
| 2026-09-17，16:50录制文件 | 软件命令约±7000Hz时编码器不跟随，启动高速加速保护排查 | S2；没有STEP波形，不能说已测得真实脉冲频率。 |
| 2026-09-17～18，事件日期不精确 | 新增B/H高速同向加速限制；每10ms端点增量分成四个2.5ms子步；编译/烧录后现场仍反馈会卡 | S1/S2；同一事件合并，未证明单独平滑解决失步。 |
| 2026-09-17，17:10/20:35录制文件 | CSV仅重连标记/表头；固件40字段与旧面板39字段不匹配 | S1/S2；录制工具问题，不能从空CSV推断车没输出。 |
| 2026-09-17 20:41，后期代码注释所引日志 | enc2长段无计数，增加可信编码器选路机制 | S1/S6；接线原因仍是假设；双路同命令不证明两路实际运动相同。 |
| 2026-09-18，S1引用周报时间 | 描述速度环→目标角、直立PD→频率增量→积分的控制结构 | S1/S2；设计变更的单次实施时刻不完整。 |
| 2026-09-22～23，CSV与阶段报告 | 多种细分和换向软窗口组合仍出现不跟随；记录换向相关性 | S1/S4；缺少同条件对照，不严格否证扭矩/衰减原因。 |
| 2026-09-23 20:46起，S1历史操作时间 | 成本考虑暂停DRV8434，转向BTT TMC2209 | S1；选型意向不等于实机验证。 |
| 2026-09-24，S1历史操作时间 | 参考TI衰减模式资料提出固定mixed decay嫌疑 | S1/S4；没有本车相电流波形，保持假设。 |
| 2026-09-28，S1历史操作时间 | BTT双板UART配置、接线电平与读回排查；写入计数非零 | S1/S3/S5；write-only并未证明寄存器生效。 |
| 2026-09-28 16:24～17:17，S1历史操作时间 | 后轮单向转；载板拔下DIR电平恢复；再次交换后故障跟随某块TMC载板 | S1/S5；现场交换反馈定位到载板，具体内部缺陷未测。中途“后轮插座坏”结论撤回。 |
| 2026-09-28 17:24～19:25，操作记录及阶段报告 | 前DRV+后TMC混配、翻后轮极性；仍反馈丢步；SC读回未闭环 | S1/S5；混配细分、模式、电流和参数同时变化。 |
| 2026-10-10，仅日期可靠（S1声明） | MKS R9模式查证，S1记“出厂SC” | S1；与S3后来短接SPREAD至VIO叙述冲突，见C02。 |
| 具体日期未知，SC改接在软件审查之前 | 现场反馈SPREAD接VIO、声音变大，但仍有卡住 | S3；缺板件唯一标识和焊前焊后测量，不用声音证明模式。 |
| 2026-10-14～15阶段，阶段记录日期 | 独立STEP/DIR固件；后轮方向极性调整 | S3/S6；不把烧录通过当作方向实测通过。 |
| 2026-10-15，20:43录制文件 | enc1停住而命令升高；随后恢复运动，展开软件审查 | S3；MCU129.189～129.939s命令1210→3500Hz、enc1=-3039，未采STEP波形。 |
| 2026-10-15，阶段记录日期 | 实施STEP边沿调度、过零保护、回复入队、超时重同步；编译和主机模拟通过 | S3/S6；此时明确未烧录，不等同实机成功。 |
| 2026-10-20，阶段记录日期及烧录输出 | 烧录修复版，校验通过；现场反馈稳定，剩漂移 | S3；也降低了部分速度/加速参数，不能单独归因软件或SC。 |
| 2026-10-20，09:55录制；MCU149.623～389.623s | 无人干涉末四分钟，平均pitch约9.968°，X/Y=0，位置漂移且无回位命令 | S3分析摘要；需配CSV复算。先前O变化属现场调参，不当故障。 |
| 2026-10-20，10:42录制；MCU164.333～404.333s | X=0.5、Y=1、M=30时回位目标常达Y上限，位置仍偏移 | S3；只能说明回位跟踪未闭环，不说明改X单独有效。建议K=-0.05未验证。 |
| 2026-10-22，阶段记录日期及烧录输出 | 现场指定O=4、X=5、Y=1、M=0固件默认，烧录Verified OK | S3/S6；配置已写入，不等于精确回原点验证。 |
| 2026-10-22，21:24录制文件 | S1记录长时数据及enc2不再恒0 | S1；缺维修动作，不能宣称接触故障根治。 |
| 2026-10-23，阶段记录日期 | 面板22项默认同步截图及固件，AST/语法核对通过 | S3/S7；待发默认和车端值需区分，重启面板才载入。 |
| 2026-10-24，20:06录制文件 | S1记录进一步长时运行，面板O到6、X=5 | S1；与O=4的上电默认不矛盾，本轮未做失步率分析。 |
| 2026-10-27，阶段记录日期 | 建展示目录；S1导出跨会话历史 | S1/S3；当时未上传GitHub。 |
| 2026-10-28，阶段记录日期 | 导入四份脱敏来源、补后期阶段记录、完成工程归集与规范化报告 | 原件留中转区；未修改控制程序、未重新烧录或发布。 |

## 阶段结论与验证边界

硬件曾有独立问题（电平/供电异常、坏载板随交换迁移），软件也存在逻辑与时序风险。SC配置后仍失败，后续软件和参数调整后得到稳定反馈。因此“只要SC就能解决”证据不足；“已证明某个软件缺陷是唯一根因”同样证据不足。

下一步若做因果验证，应固定板件、供电、限流、细分、参数和测试动作，记录实际STEP/DIR波形及编码器，并只改变一种模式或一种软件机制。对照试验与当前稳定版本分别管理。
