jinxiao123580-hub/balance-car/history/reports/records/report_control_20260917_20260918.md

# 控制结构与遥测联调阶段报告

| 属性 | 内容 |
| --- | --- |
| 报告编号 | PH-CONTROL-20260918 |
| 事件范围 | 2026-09-17～18，部分早期事项日期未知 |
| 规范化日期 | 2026-10-28，Asia/Shanghai；时分未记录 |
| 系统 | STM32F407ZG、BMI270、步进驱动及编码器 |
| 阶段状态 | 高频不跟随仍复现；遥测格式不一致影响后续验证 |

## 1. 阶段目标

建立适用于步进车的控制链，区分姿态失稳、频率积分累积、驱动不跟随与遥测故障。

## 2. 已有背景

早期由横装MPU6050转为竖装BMI270，安装轴向和前后方向经过适配；具体标定时间及逐次实现记录不完整。速度方向约定speedLoopDirection=-1已在阶段记录中确认为实机配置。

控制算法经过多种尝试，最终主链为：

```text
位置误差 → 受限目标速度 → 速度PI → 目标倾角
目标倾角与姿态 → 直立PD → 频率增量 → 积分频率 → STEP命令
```

直接STEP制动与速度预测试验通道后续保持关闭，不将这些讨论方案视为当前已启用功能。

## 3. 关键事件与时间

| 时间依据 | 实施或观察 | 结果 |
| --- | --- | --- |
| 2026-09-17 16:50:09，CSV文件名 | 记录高频命令与编码器不跟随 | 存在约±7000Hz的软件命令，不能据此确认物理STEP波形 |
| 2026-09-17，时分未知 | 增加B/H高速同向加速保护 | 编译通过，阶段记录包含烧录通过；效果未单独闭环 |
| 2026-09-17 17:10:45与20:35:34，CSV文件名 | 新格式录制失败 | 文件仅重连标记或表头，不能用于运动分析 |
| 2026-09-18，时分未知 | 每10ms端点分为四个2.5ms子步 | 最终烧录校验通过，随后仍有卡顿反馈 |

## 4. 试验配置与实现

阶段记录中的默认组为：

```text
P=1000 D=100 O=11 Z=0
L=7000 S=400 R=0.1 B=4000 H=150
K=-0.02 I=0 N=2 W=50 J=2 E=0
X=0 Y=0 M=30 F=5 G=10 T=0 U=0
```

高速且继续同向加速时采用min(H,S)，反向制动采用S。每10ms计算频率增量端点，在四个控制周期中等分执行。该策略不增加电机可用扭矩，不能保证消除失同步。

## 5. 数据依据与异常

ble_tune_log_20260917_165009_185_p11420.csv的历史分析列出MCU44404、80904、104654、119404ms附近的高频命令/编码器静止片段。后两段伴随倾角增大。此证据指向指令与反馈不一致，不足以区分机械失步、信号问题与编码器漏计。

新增balAccelEffectiveLimitHzStep后，固件40项遥测与旧面板39项校验不一致；失败录制为ble_tune_log_20260917_171045_688_p11420.csv和ble_tune_log_20260917_203534_858_p11420.csv。

参数输入区与设备回显曾不同：输入K=-0.09/I=-0.09，设备仍显示K=-0.02/I=0。未确认下发的输入不作为运行配置。

## 6. 阶段结论

保护和平滑版本尚未消除现象。电流、供电、共振、输出时序和编码器均是待核对因素。细分跳帽位序存在歧义，不能仅依据011/100字符串缩放参数。

早期材料没有包含后续TMC实机阶段，不代表整个项目未采用TMC。后续参见[换向异常报告](report_reversal_20260923.md)与[集成进展报告](report_integration_20260928_20261028.md)。
