jinxiao123580-hub/balance-car/history/reports/records/report_development_20260520_20261024.md

# 硬件与控制系统开发阶段总结

| 属性 | 内容 |
| --- | --- |
| 报告编号 | PH-DEVELOPMENT-20261024 |
| 事件范围 | 2026-05-20文件记录至2026-10-24试验记录 |
| 初始汇编时间 | 2026-10-27 20:32～21:00，原资料标注 |
| 规范化日期 | 2026-10-28，Asia/Shanghai；时分未记录 |
| 资料基础 | 汇报材料、工程、CSV、阶段记录与操作记录 |
| 限制 | 部分事件由文件时间或后期汇编定位，未取得完整逐次代码版本 |

## 1. 开发路线

直流减速电机方案 → A4988步进阶段 → DRV8825阶段 → BTT TMC2209及混配试验 → MKS TMC2209独立STEP/DIR阶段。更换过程伴随主控、固件、细分和参数调整，不视为同条件横向对比。

## 2. 时间与进展

| 时间 | 阶段工作 | 验证与限制 |
| --- | --- | --- |
| 2026-05-20，汇报文件时间 | 购买车及直流驱动选型资料 | STM32F103RC、37GB-520、TB6612、MPU6050等为材料记录，不代表当前配置 |
| 不晚于2026-08-16，历史汇报范围 | 42步进+A4988，改1/8细分、增加电容和结构垫片 | 缺代码和CSV；主控、供电与限流未完整记录 |
| 日期未知，DRV阶段之前 | 更换DRV8825及相关系统迭代 | 不能用PPT修改时间确定更换发生于某两天 |
| 2026-08-17，文档日期 | 蓝牙遥测工具建立 | 电脑端就绪，当时实机联调待完成 |
| 2026-09-01，变更记录 | 直立输出缩放0.7、速度直接叠加 | 编译通过，烧录失败；无实机效果结论 |
| 2026-09-17～18 | 编码器可信选路、B/H保护、子步平滑及目标倾角结构 | 阶段仍有卡顿；遥测字段错配曾导致空CSV |
| 2026-09-22～23 | 细分和换向试验，评估DRV8434 | 多变量同时变化，不作严格因果归纳 |
| 2026-09-23 20:46起，历史操作时间 | 因成本转向TMC2209 | 选型过程，非效果验证 |
| 2026-09-24 13:34～13:47，历史资料核对时间 | 参考TI资料评估衰减模式 | 属器件机制参考，缺本车相电流对照 |
| 2026-09-28 13:24～14:17，历史操作时间 | UART接线、电平与独立测试 | 存在连接反馈，但寄存器回读仍未证实 |
| 2026-09-28 16:24～17:17 | 载板交换及DIR异常定位 | 故障跟随某块载板，内部缺陷未知 |
| 2026-09-28 17:24～19:25 | 前DRV+后TMC混配和方向调整 | 仍反馈换向异常；SC请求无读回 |
| 2026-10-10，仅日期可靠 | MKS焊位和模式查证 | 与后续改焊记录有冲突，不能泛化出厂模式 |
| 2026-10-15～20 | STEP调度和换向、阻塞机制修复，随后烧录 | 软件实施与稳定观测由后期报告补充 |
| 2026-10-20～24 | 位置环和机械平衡点整定、长时数据记录 | 编码器2出现活动；位置保持未完成统一验证 |

## 3. 关键证据

### 3.1 早期A4988阶段

汇报材料第183～186页记录选择A4988、全步振动、细分与垫片调整、供电损坏及抱持不转。资料不包含完整测试条件。早期“EN拉高使能”解释不正确，已在技术勘误中更正；原始说法不作为接线指南。

### 3.2 编码器与不跟随

2026-09-17 20:41的历史日志引用记录enc2长段无计数，随后增加可信通道选路。后期enc2活动只能证明对应时段有信号，缺维修动作记录，不能确认永久修复。

09-23的锁定率等数值是历史统计，未在同一硬件/参数条件下重算。不同细分仍复现现象，但不足以否证全部扭矩或衰减机制。

### 3.3 BTT载板与UART

09-28交换记录推翻了中途“后轮插座异常”的单一判断，支持载板级缺陷。UART发送计数及MCU编程校验不证明驱动寄存器接受设置；未取得version、IFCNT、GCONF成功读回。

### 3.4 MKS阶段

关于“出厂已为SC”和“后期短接SPREAD至VIO”的记录尚未完全对应到同一板件。声音变化不是独立的模式验证。后期软件与参数同时改变，不能把稳定结果只归到模式。

## 4. 数据范围

历史材料涉及1/32、1/16、1/8组合及后期1/16配置请求。具体跳帽电平不完整，微步软件请求与实际硬件状态分别记录。

10-22和10-24存在长时CSV，包含X=5及O调整；原记录分别引用MCU14163～827163ms与62625～745375ms。持续有数据不等于持续自主平衡，且未完成统一锁定统计。后续稳定片段分析见[集成进展报告](report_integration_20260928_20261028.md)。

## 5. 未完成事项

供电、限流、细分、板件标识与实测波形需形成统一记录；位置尺度、原点保持和反馈方向需验证；机械装配依赖与EDA完整性需复核。历史材料存在的结论冲突见[技术勘误](../conflicts.md)，文件及指纹见[证据索引](../sources.md)。
