jinxiao123580-hub/balance-car/history/reports/records/report_hybrid_20260928.md

# 混配驱动阶段验证报告

| 属性 | 内容 |
| --- | --- |
| 报告编号 | PH-HYBRID-20260928 |
| 阶段截止时间 | 2026-09-28 19:25，Asia/Shanghai，阶段记录标注 |
| 规范化日期 | 2026-10-28；时分未记录 |
| 硬件配置 | 前轮DRV8825：PA6/PA7；后轮TMC2209：PA8/PB0、PDN_UART=PA9 |
| 状态 | 方向配置调整完成；换向异常与SC配置验证尚未闭环 |

## 1. 阶段目标

将TMC2209用于换向试验，区分载板DIR异常、UART配置状态与平衡控制问题。

## 2. 实施与验证

- 两块BTT TMC2209的交换测试记录表明，一块载板放到哪侧，哪侧出现换向异常；拔下载板后MCU DIR电平恢复。故障定位到载板级，具体内部缺陷未测。
- 保留可用TMC于后轮，前轮恢复DRV8825，设置TMC_FRONT_ACTIVE=false。
- 根据实际轮向修改后轮motor2Invert。该阶段极性与后续MKS配置不同，不作为所有板型的通用设置。
- 主固件编译、ST-Link编程与校验通过；驱动配置采用write-only，发送spreadCycle、1/16和1200mA的请求。
- 阶段记录仍反馈丢步；未获得version、IFCNT和GCONF的成功读回。

## 3. 数据与参数

ble_tune_log_20260928_173505_691_p32248.csv，阶段记录MCU152729～176979ms：

```text
P=1000 D=100 O=11 Z=0 L=3500 S=200
B=1000 H=40 R=0.1 K=-2 I=0 N=2
rawSpeedEncoderMode=1
```

enc2仅有少量变化，融合速度主要依赖enc1。前轮DRV细分与后轮是否一致尚未确认。

## 4. 结果判定

MCU烧录成功与TMC寄存器写入成功分别判定。非零txCount只证明主控尝试发送；无回读时不声称模式、电流和细分已经生效。更换驱动、混配、方向修改和调参同时发生，结果不能单独归因于SC或某项代码。

## 5. 后续计划及演进

阶段计划包括核对UART电平、读回寄存器、统一细分与复测。后续进入MKS独立STEP/DIR方案并进行软件时序修复，见[集成进展报告](report_integration_20260928_20261028.md)。

历史材料中的模式判断和因果推断以[技术勘误](../conflicts.md)为准。
