jinxiao123580-hub/balance-car/history/reports/records/report_reversal_20260923.md

# 换向异常阶段试验报告

| 属性 | 内容 |
| --- | --- |
| 报告编号 | PH-REV-20260923 |
| 阶段截止时间 | 2026-09-23 20:44，Asia/Shanghai，原阶段记录标注 |
| 规范化日期 | 2026-10-28；时分未记录 |
| 硬件阶段 | STM32F407ZG、BMI270、DRV8825、步进电机及编码器 |
| 状态 | 多种组合仍存在换向不跟随，根因未闭环 |

## 1. 目标与现象

处理方向反转后的短暂不跟随和车体倾角增大。阶段数据将异常与换向关联，但没有同步采集STEP/DIR及相电流波形。

## 2. 实施内容

对1/32、1/16、1/8细分及相应频率参数开展比较，加入250ms、增量系数0.25的换向软窗口，评估DRV8434等替代方案。速度环方向约定保持speedLoopDirection=-1。

## 3. 记录与结果

| 材料或组合 | 阶段记录结果 | 证据限制 |
| --- | --- | --- |
| ble_tune_log_20260923_195736_949_p17656.csv | 原统计记录末段约55.2s内9次锁定与换向相邻 | 本次未重算检测算法，软件命令不是脉冲测量 |
| 1/32组合 | 历史统计约0.075～0.267次/s | 非统一条件下的性能指标 |
| 1/16组合 | 历史统计约0.116～0.164次/s | 参数与记录区间不同 |
| 1/8组合，ble_tune_log_20260923_203020_049_p24520.csv | 历史统计约0.136次/s，软窗口内仍出现异常 | O、K、L/S及编码器状态也变化 |

不同细分的组合均未稳定消除现象。由于多变量变化，不据此严格否证扭矩不足，也不认定DRV8825衰减模式为唯一根因。

## 4. 阶段配置

```text
P=1000 D=100 O=8 K=-0.02
L=1750 S=100 B=1000 H=40
REVERSAL_SOFT_TICKS=25
REVERSAL_SOFT_LIMIT_SCALE=0.25
```

以上为阶段记录中的固件组，不代表所列全部CSV全程采用该配置。细分跳帽与电平未最终确认，不能直接沿用到其他版本。

## 5. 遗留事项与后续进展

供电、限流、实际细分与相电流尚需核对；编码器2存在间歇无计数。DRV8434方案随后因成本因素暂停，进入TMC2209验证。后续见[混配驱动报告](report_hybrid_20260928.md)。

相关历史解释、VREF换算和因果结论已在[技术勘误](../conflicts.md)中列明。
