jinxiao123580-hub/balance-car/history/versions/imported-history/report_control_20260918.md

# 控制与数据链路阶段状态报告

| 属性 | 内容 |
| --- | --- |
| 报告编号 | PH-STATUS-20260918 |
| 阶段日期 | 2026-09-18；时分未记录 |
| 规范化日期 | 2026-10-28，Asia/Shanghai |
| 适用阶段 | BMI270、DRV8825及高频保护/子步平滑版本 |

## 1. 实施进展

速度环通过目标倾角参与直立控制，直接制动及预测通道关闭。加入B/H高速同向加速限制，并将每10ms频率端点变化分成四个2.5ms子步。阶段记录包含ST-Link校验通过，但随后仍有卡顿反馈。

## 2. 配置记录

```text
P=1000 D=100 O=11 Z=0 L=7000 S=400 R=0.1
B=4000 H=150 K=-0.02 I=0 N=2 W=50 J=2 E=0
X=0 Y=0 M=30 F=5 G=10 T=0 U=0
```

此为历史默认值，不代表当前运行配置。B/H限制高速同向继续加速；S为每10ms端点增量限幅。

## 3. 验证结果与问题

旧CSV记录约±7000Hz命令而编码器不动；未采集实际STEP波形，不能断言定时器输出已经验证。新遥测增加balAccelEffectiveLimitHzStep后，40字段与旧面板39字段不一致，造成仅表头或重连标记的失败录制。

细分跳帽位序尚未核实。对于标准M0-M1-M2顺序，011属于1/32、100属于1/2；现场字符串不保证与该顺序一致。参数缩放必须建立在真实细分已确认的基础上。

## 4. 测试计划及状态

当时提出关闭外环后评估电机速度/加速度包络，并逐步增加S、R、L。这是待实施边界试验计划，不是已验证的推荐参数。供电、限流、共振、时序和编码器仍需核对。

详细依据及后续进展见[控制与遥测联调报告](../../reports/records/report_control_20260917_20260918.md)和[集成报告](../../reports/records/report_integration_20260928_20261028.md)。
