jinxiao123580-hub/balance-car/history/versions/imported-history/report_development_20260814_20261024.md

# 多阶段开发记录归档摘要

| 属性 | 内容 |
| --- | --- |
| 归档编号 | PH-ARCH-DEV-20261024 |
| 记录覆盖 | 2026-08-14相关材料至2026-10-24；附2026-05-20文件前史 |
| 原汇编时间 | 2026-10-27 20:32～21:00 |
| 规范化日期 | 2026-10-28，Asia/Shanghai |

## 1. 范围

材料涵盖A4988、DRV8825、BTT及MKS TMC2209、控制结构演进、编码器异常与工具链。包含多种时间依据，部分段落只确定日期或相对先后。

## 2. 归档处理

跨阶段内容统一整理至[开发阶段总结](../../reports/records/report_development_20260520_20261024.md)，重复说明在本摘要中不再展开。原始工作记录保留在仓库外中转区，可按源文件指纹追溯。

## 3. 结论限制

多变量试验不能严格证明唯一失步根因；UART发送成功不等于寄存器写入成功；MKS出厂模式记录与后续改焊记录存在差异；编码器有活动不等于永久修复。相关说明见[技术勘误](../../reports/conflicts.md)。
