jinxiao123580-hub/balance-car/history/versions/imported-history/report_direction_20260928.md

# 后轮单向转动故障分析阶段报告

| 属性 | 内容 |
| --- | --- |
| 报告编号 | PH-DIR-20260928 |
| 数据截止 | 2026-09-28 16:20:39，记录所引文件修改时间 |
| 规范化日期 | 2026-10-28，Asia/Shanghai |
| 适用阶段 | BTT TMC2209双板、GPIO模拟UART write-only |

## 1. 故障现象

现场观察前轮方向正确、后轮单向转动。控制程序中的后轮命令存在正负变化，不能仅通过翻转极性解释持续单向现象。

## 2. 试验条件

前轮PA6/PA7，后轮PA8/PB0；UART分别PA2/PA9。阶段请求为spreadCycle、1200mA、1/16，尚无读回。此阶段motor2Invert=true，后续混配与MKS极性按各自记录区分。

## 3. 数据结果

ble_tune_log_20260928_162008_034_p32248.csv记录89条有效行，MCU11559～35559ms；m1Hz与m2Hz一致，后轮命令8次变号，enc2恒0。前一份160142录制包含191条及一次MCU时间回退，不能视为连续单次试验。

| MCU ms | m1Hz | m2Hz | enc1 | enc2 |
| ---: | ---: | ---: | ---: | ---: |
| 11559 | -1750 | -1750 | 6859 | 0 |
| 17059 | 592 | 592 | 12593 | 0 |
| 20309 | -417 | -417 | 9323 | 0 |
| 32059 | 111 | 111 | 13418 | 0 |
| 34809 | -494 | -494 | 10942 | 0 |

该段参数P=1000、D=100、O=8、L=1750、S=100、B=1000、H=40、R=0.1、K=-0.02、I=0、N=2、X=0；速度采用enc1。

## 4. 判定与后续确认

软件命令已换向，但CSV未包含PB0/载板DIR电压和物理轮向。enc2为0既可能涉及通道故障，也不能否定现场观察到的单向运动。发送字节数不能替代寄存器读回。

随后进行电平与交换排查，17:17左右的记录将故障定位到某块载板。后续结论见[混配驱动报告](../../reports/records/report_hybrid_20260928.md)；载板内部故障机理未验证。
