jinxiao123580-hub/balance-car/history/versions/imported-history/report_telemetry_20260817.md

# 蓝牙遥测工具联调进展报告

| 属性 | 内容 |
| --- | --- |
| 报告编号 | PH-TELEM-20260817 |
| 事件日期 | 2026-08-17；原记录时分不完整 |
| 规范化日期 | 2026-10-28，Asia/Shanghai |
| 阶段状态 | 电脑端工具就绪，实机联调待完成 |
| 适用版本 | 早期UART5/遥测格式，不作为当前接线说明 |

## 1. 阶段目标

为姿态摆幅扩大与电机偶发不跟随建立实时接收、绘图及CSV记录链路。

## 2. 已完成内容

固件已有namespace Telemetry及环形缓冲发送；电脑端完成ble_telemetry_plot.py、启动器及六面板绘图。历史记录包含Qt绘图后端、批处理换行和设备名称适配的修正。

早期设计每2.5ms最多发送3字节，数据约51字段，周期快照D与停机事件E分别记录。字段后缀100/1000表示整数缩放。

## 3. 接口与带宽

早期接口为UART5：PC12发送、PD2接收，共地及3.3V逻辑。原记录115200与后续9600说明不一致，具体波特率以同一版本固件与模块配置匹配为准；后期系统使用USART3，不能直接沿用该接线。

640字节左右的5Hz记录需求超过1.2KB/s发送预算，存在降频或丢弃。名义遥测频率不视为实际到达采样率。

## 4. 验证状态

电脑端脚本与绘图准备完成；当时接线、模块串口配置及实机数据链路未完成闭环。该记录不证明当日已稳定接收车辆数据。

## 5. 后续工作

核对接口版本、供电与波特率，确认有效数据及字段数，随后分析姿态包络、输出变化和停机事件。当前使用入口见[使用说明](../../../GETTING_STARTED.md)，历史控制演进见[控制阶段报告](../../reports/records/report_control_20260917_20260918.md)。
