jinxiao123580-hub/balance-car/docs/validation/analysis/fixed-angle-request-20261030-152627/report.md

# 固定 ±2°前后控制修改依据

记录日期：2026-10-30，Asia/Shanghai。原始 CSV 按 utf-8-sig 读取，完整行须各列均存在且无额外列；保留原文件。本文分析的是修改前的位置倾角版，不能作为新固定倾角版的实车验收。

## 记录结论

15:24记录共44行完整遥测，实际运动配置均为0.005°/计数、上限0.30°。15:26记录共363行，其中前12行仍为0.30°，后351行为0.50°，位置P均为0.005。因此最新记录已证实0.50°确实生效，不能沿用14:23记录的“参数未应用”结论。

15:26记录有6个活动序号：1个到位（reason=2），5个任务超时（reason=7）。这说明旧位置运动尚未可靠完成，不足以单独证明失步、驱动模式或某个增益是唯一根因。记录期间O在-1°至5°间有人工调参快照，不能将全部目标角变化算作控制器自发变化。

| 序号 | 活动采样 | 终态 | 目标计数 | 首→末采样位置 | 倾角输出范围/° |
| --- | ---: | --- | ---: | --- | --- |
| 2343734444 | 24 | 7 | 1694 | 1628 → 1746 | -0.190 ～ 0.221 |
| 2343734445 | 24 | 7 | 2001 | 2060 → 2129 | -0.500 ～ -0.011 |
| 2343734446 | 13 | 2 | 2161 | 2169 → 2174 | -0.075 ～ 0.028 |
| 2343734447 | 24 | 7 | 2238 | 2180 → 2196 | -0.021 ～ 0.210 |
| 2343734448 | 24 | 7 | 2204 | 2257 → 2232 | -0.202 ～ -0.025 |
| 2343734449 | 24 | 7 | 2315 | 2272 → 2169 | -0.024 ～ 0.217 |

表中位置为编码器累计计数，首末为2Hz活动采样，不能当作完整任务起止位置或毫米。终态取同序号最后一行。

## 本次实现及验证边界

按用户要求改为按住前后按钮，目标相对实时平衡角O固定±2°。不再按位置误差生成前后目标。移动及回零期间暂时旁路速度/驻车角度修正，直立PD和STEP保护继续运行；回零后1秒渐入原速度环。手动倾角轨迹限制为2°/s与4°/s²，从静止到2°约1.73秒，中途释放/反向先减速再改变目标。详见[控制与协议](../../../turning.md)。

本轮black_f407zg编译通过，RAM8088B、Flash83724B；轨迹、真实main.cpp目标合成/命令分支、STEP时序、位置交接及离线Qt回归通过。未烧录，未验证实际前后方向、位移、松开后的机械制动与稳定性。固定倾角持续保持可能持续加速，不能将软件斜坡当作不会倾倒的保证。

## 来源校验

- [ble_tune_log_20261030_152457_452_p29240.csv](../../recordings/ble_tune_log_20261030_152457_452_p29240.csv)：SHA256 `05f7ec990b57a181f657a7971dcb49b19b31d9db59ffedbf81360a6000f92958`。
- [ble_tune_log_20261030_152627_943_p29240.csv](../../recordings/ble_tune_log_20261030_152627_943_p29240.csv)：SHA256 `386e9ae9b239d0f801a053d575aaacaf094ba2d0830d76e468f8ba4ec4a269a2`。
