jinxiao123580-hub/balance-car/docs/validation/analysis/fixed-angle-review-20261030-173422/report.md

# 固定倾角版17:34记录分析

分析日期：2026-10-30，Asia/Shanghai。此次只分析，不修改固件、面板或烧录。

## 结论

当前正向+2°动作过强，三次均在松开后的采样中出现大角度偏离与1750Hz输出饱和。负向−2°没有相同表现，不能简单概括为双向2°都必然失稳，也不能仅凭此记录排除平衡角偏置、动力学方向差异或人工扶车影响。建议下一轮正负先按相对O ±0.5°测试，再按0.1～0.2°递增。这个建议是调试起点，尚未实车验证，不保证必能移动或稳定。

## 记录与参数

读取最新ble_tune_log_20261030_173422_570_p6548.csv，utf-8-sig。190条解析记录中187条列数完整，3条缺列/多列记录排除。全部完整记录manualControlMode=5，有74个遥测数值与22个参数快照。P=1000，D=100，K=-0.02，I=0，X=5。O开头4行是4°，随后183行为2°；所有手动动作均在O快照为2°之后。O参数快照不是车端参数确认时间戳，不能用于精确定位调参瞬间。

## 正向操作

| 正向活动采样区间/开机秒 | 首个零请求采样/秒 | 随后最大俯仰角 | 输出峰值 |
| --- | ---: | ---: | ---: |
| 41.267～42.267 | 42.767 | 15.15° | 1750Hz |
| 72.267～73.267 | 73.767 | 42.24° | 1750Hz |
| 111.267～112.267 | 112.767 | 47.59° | 1750Hz |

这些区间只描述2Hz采样，不能当成精确按住时长。正向实际目标角接近O+2°=4°，并非只是输入框改值。第一段松开样本平滑偏移仍为+1.990°，第二段+1.951°，第三段+1.682°且当时变化率仍为+0.515°/s。后者说明中途释放后先平滑减小变化率，短时间仍继续增加倾角。此行为符合轨迹连续设计，但机械系统可能已积累过多速度。

全文件fallStopCount一直为0，而manualNeedsZeroBits在大偏角后变3、auth降0。这不能证明没有失稳，记录已直接显示大角度偏离；也不能单靠CSV判断是否有人扶车/抬车。

## 负向与方向差异

共6段−2°活动请求，最长活动采样跨度6秒，所有段及其后约3秒窗口最大|pitch−O|≤2.33°，最大STEP输出637Hz。多段实际俯仰接近0°，与O−2°一致。它们明显比正向温和，因此还应复核O=2°是否为当前装配与载荷下的真实平衡点，以及两方向的机械/驱动响应。此差异不能直接证明某个方向电流不足或电机故障。

## 交接版本尚不一致

共20个姿态偏差小于5°、且正常速度环恢复权重介于0和1的完整采样，positionHoldSuspended全为0，位置误差也不为0。例如57.267秒权重0.362、位置误差−45.5计数；98.767秒权重0.058、位置误差−12.5计数。

另外，后两次正向操作在位置环仍暂停、位置误差为0时已经达到1750Hz上限（73.767秒、113.267秒），不能将起始失稳全归为位置环打架。

这与最新源码“恢复权重未满时驻车目标仍跟随当前位置、暂停位置环、误差为0”的行为不一致。可以确认这份日志未体现该项最新修复，不能仅靠mode=5判定已刷入最新构建，因为修复前后模式号相同。下一轮应先确认该修复进入实车，再评价剩余制动问题。当前证据不能判断具体烧录了哪一个二进制。

## 为什么仅减小角度还不够

固定倾角运动期间旁路速度反馈。松开只把目标角平滑拉回O，不是主动给出随轮速变化的制动目标；速度环又要等倾角回零后才渐入。正向已有明显速度时，这种延迟可能来不及制动。三次正向失稳都发生在松开之后，因此需要同时关注角度幅值、松开时的速度、回零耗时及速度反馈交接，不能仅继续放慢回零轨迹。

建议先验证最新驻车同步修复，再减小到±0.5°短按对比。如果还出现松开后加速或大偏角，再调整松开时速度反馈的介入时机。2Hz记录能说明趋势，不能证明400Hz每一拍无突变，控制层面的制动效果仍需实车验证。

## 来源

[原始CSV](../../recordings/ble_tune_log_20261030_173422_570_p6548.csv)。SHA256：`b73c19e41c7760cc9d9cee4cfe30fc7106760378e2bde2a6700d8a6318bd72be`。本报告与metrics.json使用同一原始文件，未修改原始CSV。
