jinxiao123580-hub/balance-car/docs/parameters.md

# 当前版本默认参数

更新时间：2026-10-28，Asia/Shanghai。参数取自当前固件声明及面板PARAMS；上电默认值不等于连接后已下发或实车已验证值。

| 命令 | 默认值 | 含义 |
| --- | ---: | --- |
| P | 1000 | 直立比例增益 |
| D | 100 | 直立角速度阻尼 |
| O | 4 | 平衡目标角，° |
| Z | 0 | 直立角度死区，° |
| L | 1750 | STEP频率上限，Hz |
| S | 100 | 常规频率端点增量限幅，Hz/10ms |
| B | 1000 | 高速同向加速保护起点，Hz |
| H | 40 | 高速继续加速增量上限，Hz/10ms |
| R | 0.1 | 直立PD到频率增量比例 |
| K | -0.02 | 速度比例增益 |
| I | 0 | 速度积分增益，当前关闭 |
| N | 2 | 速度修正角上限，° |
| W | 50 | 速度积分累积限幅 |
| J | 2 | 速度积分启用误差门槛 |
| E | 0 | 速度微分增益 |
| X | 5 | 位置误差到目标速度的比例 |
| Y | 1 | 最大回位目标速度，count/50ms |
| M | 0 | 位置死区，计数单位 |
| F | 5 | 外环全权限角，° |
| G | 10 | 外环退出角，° |
| T | 0 | 转向比例增益，当前关闭 |
| U | 0 | 转向微分增益，当前关闭 |

## 配置口径

面板输入、设备PAR回显和CSV参数标签分别核对。更改细分后，应重新核对STEP频率域参数与实际转速，不直接沿用旧组。

I=0时不产生速度积分；J=2而Y=1时，静止附近的小回位速度误差可能达不到积分门槛。X较大但目标速度已达Y限幅时，继续增加X不会提升最大目标速度。

本表描述软件配置，驱动器实际电流、细分与模式需要由载板装配和电平记录确认。
