jinxiao123580-hub/balance-car/history/versions/imported-history/report_telemetry_legacy.md

# 早期蓝牙遥测系统技术说明

| 属性 | 内容 |
| --- | --- |
| 文档编号 | PH-TELEM-LEGACY |
| 版本时间 | 原资料标注2026-08-19；未核对精确实施时刻 |
| 规范化日期 | 2026-10-28，Asia/Shanghai |
| 状态 | 历史协议参考，不作为当前接线和参数基线 |

## 1. 接口与功能

早期采用JDY-23及UART5，PC12发送、PD2接收，串口9600的说明与更早115200记录不同。电脑端工具提供动态表头解析、实时绘图及CSV记录。当前主固件采用USART3，应按当前实现核对。

## 2. 数据格式

早期协议以#开头表示注释和表头，D行为周期快照，E行为保护停机事件。字段后缀100及1000表示相应缩放。名义快照频率与实际到达频率可能因带宽限制不同。

## 3. 诊断用途

姿态、角速度、编码器、指令跳变和保护事件用于交叉分析；软件请求与实际物理输出分开判定。各协议版本字段数量不同，不能把不匹配的录制当作有效数据。

## 4. 当前入口

使用[运行说明](../../../GETTING_STARTED.md)中的当前面板和[数据目录](../../data/raw/)，本文件仅保留历史接口信息。
