jinxiao123580-hub/balance-car/hardware/bom/README.md

# 物料清单编制状态

| 属性 | 内容 |
| --- | --- |
| 文档编号 | PH-BOM |
| 更新日期 | 2026-10-28，Asia/Shanghai；时分未记录 |

## 当前状态

尚未归集独立BOM。已有器件描述仅用于阶段背景，不作为完整采购清单。

## 完成要求

最终清单包含位号、型号、封装、数量、关键额定值及可替代料，并关联明确PCB版本。自制主板、驱动模块与外购器件分别登记。
