jinxiao123580-hub/balance-car/docs/design/components/README.md

# 部件说明（每个部件一个文件）

这里放"具体每个部件"的细节：型号、参数、接线、实测数据、已知问题。
原始照片/手册/截图先丢进仓库根目录的 `_inbox/`，整理后结论写进对应文件，图片放 `docs/images/` 或 `history/media/`。

## 建议字段

每个 `<部件>.md` 用同一套小标题，缺的写"未知"，不要留空：

```
## 型号与来源
## 关键参数（标来源：铭牌 / 手册 / 实测 / 卖家页）
## 接线与引脚
## 实测记录（电压、电流、温度、波形）
## 已知问题
## 待验证
```

## 当前清单

| 文件 | 部件 | 状态 |
|---|---|---|
| `mcu-stm32f407zg.md` | 主控 STM32F407ZGT6（核心板 V2.0） | 已有 |
| `imu-bmi270.md` | BMI270（400 Hz） | 已有 |
| `driver-tmc2209-mks.md` | MKS TMC2209（当前在用） | 已有 |
| `motor-ms42c.md` | MS42C/MS42CG 42 步进电机 | 已有（铭牌参数，缺矩频/电阻） |
| `encoder.md` | 增量编码器 1024 线 AB 相 | 已有（缺每圈计数实测） |
| `driver-a4988.md` | A4988（第一代，≤2026-08） | 待补 |
| `driver-drv8825.md` | DRV8825（2026-08 ~ 09-28） | 待补 |
| `driver-tmc2209-btt.md` | BTT TMC2209 V1.3 | 待补 |
| `ble-jdy23.md` | JDY-23 蓝牙模块 | 待补 |
| `power.md` | 电源与配电（12 V 2200 mAh、板载降压） | 已有（缺降压型号/电流） |
| `chassis.md` | 自建两轮车体与装配 | 待补 |

> 状态改成"已有"时，请同时更新本表，避免以后分不清哪份是最新。
> 厂商原始资料在 `docs/references/vendor/`（不入 Git），本目录只写结论。

## 不在本清单里的

WHEELTEC 资料包里的**驱控一体电机（MS42DC）**和**底盘主控/ROS 协议**本项目没有采购，也未使用，只作为原理与选型参考留在 `docs/references/vendor/WHEELTEC-MS42DC/`，不单独建部件文档。

> 文中出现的 `docs/references/vendor/...` 是**本地存档路径**：厂商 PDF、产品图与示例工程不随仓库发布（见根目录 `NOTICE.md`）。
