jinxiao123580-hub/balance-car/docs/design/components/motor-ms42c.md

# 电机：MS42C / MS42CG（42 两相混合式步进）

## 型号与来源

- **MS42C**（无编码器，283 g）/ **MS42CG**（带编码器，294 g）。
- 厂商产品信息图：`docs/references/vendor/WHEELTEC-MS42DC/MS42C_产品信息_20261103.png`、`MS42C_引脚接线_20261103.png`（用户 2026-11-03 提供）。
- 型号命名：`MS` 系列 + `42` 机座边长 42 mm + `C` 接口形态 + `G` 表示带编码器。

## 关键参数

| 项目 | 值 | 来源 |
| --- | --- | --- |
| 电机类型 | 两相混合式步进 | 产品信息图 |
| 步距角 | 1.8°（200 整步/圈） | 产品信息图 |
| 额定电流 | 1.68 A | 产品信息图 |
| 相电阻 | 1.65 Ω | 产品信息图 |
| 相电感 | 3.2 mH | 产品信息图 |
| 转动惯量 | 55 g·cm² | 产品信息图 |
| 静力矩 | 3.6 kg·cm | 产品信息图 |
| 最大转速 | ≤3000 RPM（取决于驱动/电压/算法） | 产品信息图 |
| 重量 | 283 g（MS42C）/ 294 g（MS42CG） | 产品信息图 |
| 实测 VREF | 0.9 V ≈ 1.8 A（比额定高约 7%） | 2026-09-23 交接 |

## 接线与引脚（电机侧 6PIN，XH2.54）

| 针 | 定义 |
| --- | --- |
| 1 | A+ |
| 2 | 公共线 |
| 3 | A- |
| 4 | B+ |
| 5 | 公共线 |
| 6 | B- |

- 这是**带中心抽头的 6 线接法**：用四线驱动器（A4988 / DRV8825 / TMC2209）时，通常只接 1/3/4/6，把 2、5 两根公共线悬空（按全绕组用）。
- **本车实际怎么处理 2、5 两根公共线，未记录**——拆机时确认一次，写回这里。
- 驱动器相序：DRV8825 与 TMC2209 输出相序相反，换驱动器要核对转向（2026-09-28 实测）。

## 实测记录

- 2026-09-23：VREF 0.9 V。
- 2026-09-28：DRV→TMC 相序相反，`motor2Invert` 翻转后两轮一致。
- 2026-10：MKS TMC2209 独立模式运行。

## 已知问题

- 1.68 A 额定、1.65 Ω 内阻，12 V 下电流上升快；驱动器必须限流，否则低速易过流/发热。
- 静力矩 3.6 kg·cm 是保持力矩，高速段会明显下降（手册没给矩频曲线）。

## 待验证

- 公共线（2、5）实际接法。
- 矩频曲线/高速余量——需要实测或向厂家索取。
- 轴径、法兰、安装孔尺寸（做结构件前实测）。
