jinxiao123580-hub/balance-car/docs/design/components/power.md

# 电源与配电

## 型号与来源

- 电池：**12 V 2200 mAh 锂电池**（用户 2026-11-03 口述；串数/电芯型号未记录，按 12.6 V 满电推断为 3S）。
- 电源模块：**自绘 PCB 上的板载电源**，贴片件为机器贴装（PCBA），不是外购成品模块。
- PCB 源文件：项目机械/PCB 目录下的嘉立创 EDA 工程（`*_Board1_1_*.epro2`、`*_PCB1_1_*.epro2`、`*_Schematic1_1_*.epro2`，2026-09-23）。

## 关键参数

| 项目 | 值 | 来源 |
| --- | --- | --- |
| 电池 | 12 V / 2200 mAh 锂电 | 用户口述 |
| 满电电压 | 约 12.6 V（3S 推断） | 推断 |
| 电机供电 | 12 V 直接进驱动器 VM | 接线 |
| 逻辑供电 | 板载降压出 5 V / 3.3 V | 用户口述 + 核心板供电说明 |
| 核心板 3V3 对外 | 最大 500 mA | 厂商供电说明图 |

## 配电结构（据现有信息）

```
12V 锂电 ──┬── 驱动器 VM（A4988 / DRV8825 / TMC2209）
           └── 板载降压 ── 5V ──┬── 核心板 5V（经板上 3V3 稳压）
                                └── 外设
                           └── 3V3 ── IMU / 编码器 / 蓝牙 / TMC 逻辑
```

- 具体降压芯片型号、路数、每路电流能力：**未记录**，需查 PCB 原理图后补。
- 电池是否带保护板、有没有保险丝/反接保护：**未记录**。

## 已知问题

- **上电 LC 尖峰烧过 A4988**（2026-08 汇报第 184 页）：当时的处置是外部并联大电容吸收尖峰。当前 PCB 是否保留这颗电容、容值与耐压多少，**没有记录**——换驱动器/加大电池后要复查。
- 3V3 余量只有 500 mA（若走核心板稳压），IMU、编码器、蓝牙、TMC 逻辑都挂在这路；加模块前先算电流。
- 12 V 直接进驱动器，没有软启动；频繁插拔电源仍有浪涌风险。

## 待验证

- 降压芯片型号与 5 V / 3.3 V 两路的最大输出电流。
- 电池持续放电能力（2200 mAh 的 C 倍率未知），两台 1.68 A 电机同时加速时的压降。
- 是否装了总开关、保险丝、防反接。
- 电量检测（若有分压到 ADC）接在哪个引脚。
