jinxiao123580-hub/balance-car/mechanical/printable/电机-主体连接.STL

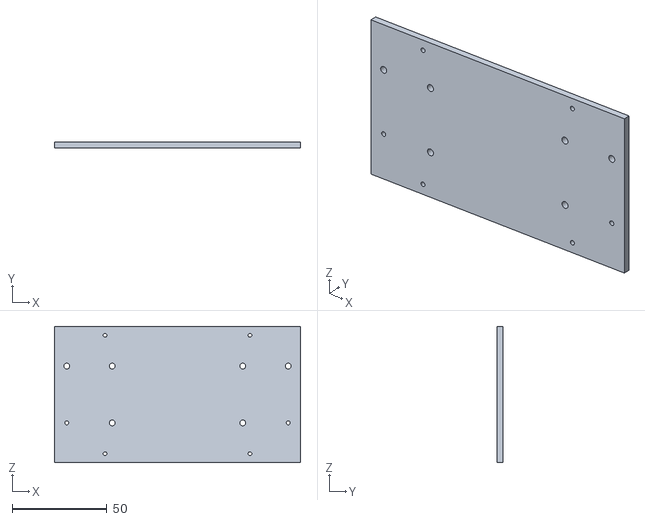
[picture p6: CAD file, 2026-10-28]
mechanical/printable/电机-主体连接.STL
130.0 x 3.00 x 72.0
