jinxiao123580-hub/balance-car/mechanical/printable/载物台.STL

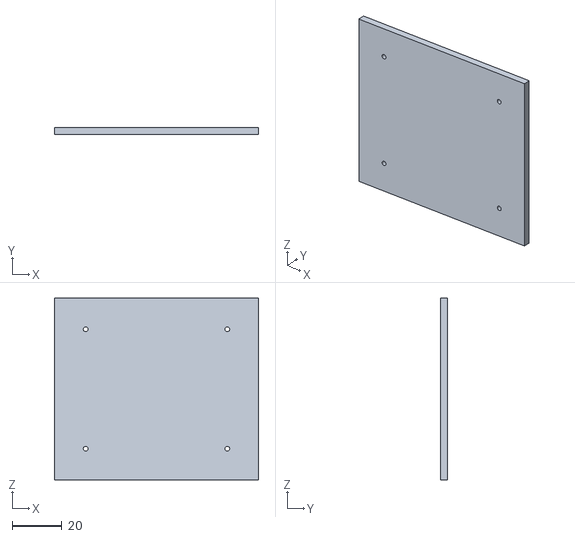
[picture p7: CAD file, 2026-10-28]
mechanical/printable/载物台.STL
82.0 x 3.00 x 73.0
