jinxiao123580-hub/balance-car/mechanical/printable/README.md

# 打印零件资料状态说明

| 属性 | 内容 |
| --- | --- |
| 文档编号 | PH-PRINTABLE |
| 更新日期 | 2026-10-28，Asia/Shanghai；时分未记录 |

## 已有资料

已归集电机-主体连接.STL与载物台.STL，原件校验通过。

## 待补信息

打印材料、方向、层高、支撑、数量和尺度验证尚未形成完整记录。可编辑源文件在../cad，STL不替代源设计。
