jinxiao123580-hub/balance-car/hardware/fabrication/README.md

# 生产资料编制状态

| 属性 | 内容 |
| --- | --- |
| 文档编号 | PH-FABRICATION |
| 更新日期 | 2026-10-28，Asia/Shanghai；时分未记录 |

## 当前状态

尚未归集已审查的Gerber、钻孔或贴片坐标文件。EDA源包存在不代表生产资料已经完成。

## 完成要求

后续生产包按板卡版本归档，记录EDA版本、制造参数、导出时间及检查结果，避免不同版本混用。
