jinxiao123580-hub/balance-car/history/experiments/README.md

# 测试工程与验证方法索引

| 属性 | 内容 |
| --- | --- |
| 文档编号 | PH-TEST-INDEX |
| 更新日期 | 2026-10-28，Asia/Shanghai；时分未记录 |

## 测试内容

| 位置 | 用途 | 验证状态 |
| --- | --- | --- |
| tmc-uart | 独立TMC寄存器读回试验 | 源工程已归集；未留成功回读记录 |
| ble-diagnostics | 蓝牙与TTL诊断 | 源码语法检查；实机连接本轮未执行 |
| openocd-legacy | 历史固定地址诊断 | 仅归档，不保证当前地址有效 |
| ../firmware/test | 主机运动回归 | 新路径运行通过 |

当前测试不替代供电、相电流、物理脉宽或机械极限试验。
