jinxiao123580-hub/balance-car/docs/validation/README.md

# 当前版本验证状态

更新时间：2026-10-30，Asia/Shanghai。对象为当前归集的固件与面板，不将旧参数或旧视频当作本版本验证。

| 验证项 | 结果 | 范围 |
| --- | --- | --- |
| 新路径PlatformIO构建 | 通过 | black_f407zg；RAM8088B、Flash83716B |
| 主机运动回归 | 通过 | STEP调频、停止重启、非法值和过零逻辑模拟 |
| 面板依赖与界面构造 | 通过 | 离线构造；未连接BLE或进行实车录制 |
| 默认参数一致性 | 通过 | 固件与面板22项默认匹配 |
| 当前默认值实车平衡 | 待统一验证 | 历史稳定片段采用其他O值，不能直接代替 |
| 位置保持 | 待完善 | 原点管理、编码器尺度和速度跟踪需核对 |
| STEP/DIR物理波形 | 待采集 | 主机模拟不是物理脉宽与抖动测量 |
| EDA/CAD完整性 | 待专用软件核验 | 文件指纹一致不证明电气或装配依赖完整 |

当前新录制默认写入[recordings目录](recordings/)。历史数据、阶段报告与旧版本统一在[history目录](../../history/)。

本次新增[差速转向](../turning.md)：限幅、平衡余量、超时、倾角和保护复位主机回归，以及离线Qt按键/失焦/能力检测/发送队列回归通过；实车转向待验证。

位置模式补充验证：运动时显式旁路位置P、目标速度归零、停止后一次捕获新驻车点、X配置保持及多次运动回归通过。

新增前后移动：双轴原子命令、速度斜坡、独立超时和前后面板回归通过。新前后移动/增大转向版本已于2026-10-29烧录，Verified OK并复位；实车验证待完成。

前后速度积分增强版：独立0.01增益、±0.5°限幅、松手/反向退出、角度/电机饱和保护及新旧遥测兼容回归通过。当前增强版已于2026-10-29烧录，Verified OK并复位；实车效果待验证。

历史阶段更新为去积分、±200手动目标版本：面板与两级固件上限一致，前后遥控时强制I项为0，高目标与停止回归通过；该版本已于2026-10-29烧录，Verified OK并复位；实车效果待验证。历史积分版本记录不代表当前源码。

历史阶段切换直接倾角遥控（MOVE=3）：速度/位置环旁路、O±0.3°真实目标合成与协议兼容回归通过；当前模式已于2026-10-29烧录，Verified OK并复位；实车效果待验证。此前速度目标与积分版本记录仅作历史。

5°倾角上限版本：4°/5°目标实际到达、松手约2秒回零及TILTMAX旧固件回退回归通过；编译通过，已于2026-10-29烧录，Verified OK并复位；实车验证待完成。

## 历史阶段：首版位置点动（2026-10-29）

前后控制已改为点击一次设置相对位置目标，MOVE=4、JOG=1；默认50计数，范围5～200。位置P/速度P串级无积分，到位后捕获当前驻车点；该版已由用户于10月30日烧录，后出现失稳，见下文。

六组回归通过：点动控制器与增量里程计、真实位置仲裁、既有倾角目标合成、差速权限、STEP时序及Qt遥控。覆盖序号去重、停止后的过时包、确认/心跳、到位与超时、编码器来源改变取消和5°姿态退出。固件black_f407zg编译通过，RAM7996B、Flash81784B。原直接倾角代码保留兼容零命令，非零前后请求被协议拒绝；相关旧回归仅用于检查原直立目标代码。

点动的角度、速度与距离为初始调试配置，尚未完成实车方向、制动距离、到位稳定性或反馈校准验证。主机逻辑测试不证明车辆实际能够完成行程，后续以新CSV中的jogActive/jogReason、位置误差和编码器来源判断。

## 平滑参考修正（2026-10-30）

用户已烧录并测试上一版点动，最新CSV出现过冲、反向振荡与reason=6退出；详见[分析报告](analysis/jog-instability-20261030/report.md)。上一版主机通过不代表已通过实车。

当前源码增加连续位置轨迹、目标速度交接斜坡，驻车捕获不清零累计位置；点动复用原K/N速度环，移除0.08私有角度增益及额外速度低通。新增真实main.cpp控制路由/停车交接测试、反向与重复目标参考连续、反馈停滞和65字段兼容测试，均通过。black_f407zg构建通过，RAM8000B、Flash81968B。本次修正尚未烧录，实车稳定性待验证；原始CSV保留。

## 平滑点动复测未通过（2026-10-30 09:48记录）

平滑参考版已由用户运行。300行完整遥测确认65字段版本与连续里程生效，但9个活动任务无到位：6次12秒超时、1次保护取消、1次心跳超时，另1个旧序号未保留终态。用户观察为原地晃动、基本不前后移动。参考领先预算与跟踪作用限幅使多数时段只保留约±1计数/50ms请求，其额外倾角贡献约±0.02°。该版本未通过前后移动验收；见[复测分析](analysis/jog-followup-20261030-094816/report.md)。本轮只分析记录，未改固件或烧录。

## 历史阶段：位置倾角P点动（2026-10-30）

针对09:48记录中的原地晃动与超时，当前点动改为独立位置P倾角，原K提供零目标速度反馈阻尼，I强制为0。运动位置P默认0.005°/计数、上限0.30°，可在面板空闲时单独下发；未改变原P/D/O/K/N和电机极性。连续位置参考保留、领先预算50计数，到位改为连续两个1秒统计窗口，并捕获位置中心。

独立通道、实际main.cpp目标合成/原K阻尼/无I、停止交接、位置连续、反向及面板71字段兼容回归通过。black_f407zg编译通过：RAM8052B、Flash83216B。本次尚未烧录，未通过实车移动验收；初始参数效果须重新测试。见[当前操作与协议](../turning.md)。

## 位置倾角版实车复测仍未通过（2026-10-30 11:05记录）

71字段遥测确认独立位置倾角已运行，参数0.005°/计数、上限0.30°。完整任务中出现整段-0.30°输出而位移未追上目标；另有越过终点的段。17个活动序号无到位事件，其中3次任务超时、5次心跳取消、1次保护取消，8个切换序号未保留旧终态。用户确认本次O=4°是重新调过的平衡点，不列为默认值恢复问题。

当前已确认位置P输出饱和，不能仅靠提高P增加饱和段作用；位移、起动与制动响应仍待辨识。公开步进B-ROBOT EVO2采用位置PD→速度PI→直立PD，不能直接跨硬件复制增益。见[CSV与公开源码对照](analysis/position-authority-20261030-110500/report.md)。本轮未改固件或烧录。

## 面板参数应用状态修正（2026-10-30 14:23记录）

229行车端配置始终0.0050/0.30°，面板待下发输入曾为0.0200/0.50°，不能把这份记录视为0.50°试验。本轮增加待应用状态、车端匹配确认、超时/断线错误和前后联锁，回归通过。用户确认设备已断电，未验证新值真实接受；本轮未改固件或烧录。见[复现与修正报告](analysis/config-apply-20261030-142358/report.md)。

## 当前源码：固定±2°平滑按住控制（2026-10-30）

15:26新记录实际配置0.005/0.50°已生效，6次任务1次到位、5次任务超时，见[数据依据](analysis/fixed-angle-request-20261030-152627/report.md)。按用户要求改为按住直接请求O±2°，速度/驻车修正暂时旁路。手动轨迹最大2°/s、4°/s²，从0到2°约1.73秒，中途松开和反向先减速再改变目标；回零后1秒恢复原速度环权重。

实际头文件轨迹、main.cpp目标合成及命令解析回归通过，包含完整/中途释放、反向、随机切换、超时与故障、零命令重启、速度I清除、原位置交接、STEP时序，以及离线Qt按住/松开、失焦/断线、旧固件联锁和74字段兼容。black_f407zg构建通过：RAM8088B、Flash83724B。当前未烧录、未验证实车方向/位移/制动/稳定性，主机通过不代表动力学验收。旧位置面板已归档，详见[当前操作与协议](../turning.md)。

## 驻车目标随手动倾角同步（2026-10-30）

修正原先仅旁路位置输出、保留旧目标且在倾角回零立即恢复驻车的问题。现在在手动倾角建立、保持、回零和1秒速度环权重恢复期间，驻车目标以400Hz跟随当前位置，位置误差与位置速度请求置0，清除旧的位置速度斜坡；交接结束才锁定最新驻车点。累计编码器坐标不重置。

真实updatePositionHold/外环仲裁回归覆盖旧驻车点、残留速度斜坡、移动中跟随、恢复权重0.4/0.999仍跟随、权重1时锁定、恢复中重新移动、来源切换和重复操作；固定倾角轨迹及实际命令分支回归通过。black_f407zg构建通过，RAM8088B、Flash83716B。本次未烧录，实车仍待验证；面板无需修改。
