jinxiao123580-hub/balance-car/docs/validation/recordings/README.md

# 当前版本录制

本目录用于当前面板新生成的CSV。2026-10-28结构调整时未将旧试验数据放入此处，也未新增实车录制。

每组试验应记录硬件、细分、电流、固件版本、参数、人工干预及起止时间。既有历史CSV保留在history/data/raw。
