jinxiao123580-hub/balance-car/docs/validation/analysis/20261029-direct-pitch/README.md

# 14:57前后指令核对

日期：2026-10-29。414行有效遥测中，前后请求与斜坡输出全部为0，不能以此作为扩大目标已经试过仍无效的证据。原始按钮状态未记录，无法唯一判断是旧面板、未启用还是其他下发问题。

源文件与指纹见summary.json；[原始CSV](../../recordings/ble_tune_log_20261029_145719_771_p29480.csv)保持不变。

当前按用户意图改用相对O的直接倾角遥控，绕过速度与位置环；新模式和车端请求回显用于先确认命令确已到达。此实现未证明具体硬件上某个倾角一定产生移动，需实车验证。
