jinxiao123580-hub/balance-car/docs/validation/analysis/20261029-forward-target-range/README.md

# 下午前后遥控记录与扩大目标范围

日期：2026-10-29。两份14点录制的有效行数为492和251，前后请求均未超过±8。14:38积分补偿范围-0.500～+0.257°；14:41范围-0.335～+0.038°，其中全局I出现0和+0.01、N出现2和10。K始终-0.02。

在现有速度环符号下，正I与负K产生不同方向的贡献，可能相互抵消；不能把这一段全部归因于额外补偿不够大。日志与用户反馈都未闭环前后速度效果。源数据指纹与参数范围见summary.json，原CSV没有修改。

按用户明确选择，当前移除新增积分，前后运动时旁路全局I，并把面板、手动目标和外环速度上限一致提高到±200。未扩大N，也未改转向。该改动提供更高目标试验条件，不证明角度是唯一原因，也不保证某个目标实车必定生效。

原始数据：

- [14:38录制](../../recordings/ble_tune_log_20261029_143827_401_p32036.csv)
- [14:41录制](../../recordings/ble_tune_log_20261029_144143_250_p32036.csv)

测试方法和范围见[当前运动说明](../../../turning.md)。
