jinxiao123580-hub/balance-car/history/administration/migration-validation.md

# 工程归集验证记录

| 属性 | 内容 |
| --- | --- |
| 报告编号 | PH-MIGRATION-20261028 |
| 实施日期 | 2026-10-28，Asia/Shanghai；时分未记录 |
| 操作范围 | 文件归集、运行验证与完整性检查 |
| 非实施项 | 固件烧录、GitHub上传、永久删除 |

## 已执行

- 211个原位置文件建立源路径/目标路径/中转路径映射，复制时逐件SHA-256校验，移至中转后再校验原件。
- 主固件在software/firmware新路径独立PlatformIO构建成功，black_f407zg；RAM7904字节，Flash77400字节。
- 主固件main.cpp与原件指纹一致：7D155CB84F41D116D17F3692096D2B28EC13DE413B4093BB4CB900DBE99AA22B。
- 新路径主机运动回归通过：STEP调频、脉宽、停止/重启、非法命令与跨零保护逻辑；不是物理波形验证。
- Python环境7827文件迁移并校验；PyQt5、bleak、matplotlib导入成功。
- 面板离屏界面构造通过，O=4/X=5/Y=1/M=0；检查时禁用BLE连接和录制。
- 面板及分析等39个Python文件语法检查通过；分析工具在新路径读取历史1457行CSV成功。
- 94份日期命名调参CSV归集；失败录制保留，没有当作有效实验。
- 公开文本按UTF-8/UTF-16检查已识别个人路径和设备地址，Markdown链接检查通过。二进制文件内部元数据未做全面公开审查。

## 尚需人工确认

- 用嘉立创EDA打开源包，确认库引用、电气规则和后续生产导出。
- 用SolidWorks打开装配体，确认是否缺外部零件；缺件需Pack and Go补齐。
- 项目汇报、照片/视频和CAD内的作者信息/第三方资产许可，发布前另行检查。
- 新目录实际BLE连接与实车运行未在本轮执行。

## 中转和后续开发

旧位置只保留必要的迁移提示或启动跳转；源文件在展示目录外中转区等待检查。内部迁移清单包含本机路径，不能上传。新仓库相对路径和文件指纹见project-inventory.json，该清单不收录运行环境、构建缓存、本机设备地址或离线厂商PDF。

后续只在software/firmware和software/ble-panel修改当前版本，历史备份放archive，不再维护旧目录中的第二份源码。
