jinxiao123580-hub/balance-car/docs/validation/recordings/ble_tune_log_20261029_143827_401_p32036.csv

time_s | ms | pitch100 | gyro100 | target100 | balPHz | balDHz | balHz | spdAng100 | auth1000 | spdDirRawHz | spdDirHz | posSpdTarget1000 | mixHz | limitedHz | finalHz | turnHz | speed1000 | raw1000 | speedAccel1000 | predSpeed1000 | predDelta1000 | spdDirUnclampedHz | pos100 | posError100 | enc1 | enc2 | m1Hz | m2Hz | accPitch100 | kalmanBias1000 | gyroIntegAngle100 | balAccelRawHzStep | balAccelLimitedHzStep | integratedSpeedHz | speedError1000 | speedP100 | speedI100 | speedAngleUnclamped100 | speedAngleLimited100 | balAccelEffectiveLimitHzStep | rawSpeedEncoderMode | dynamicRx1000 | accelMagErrX1000 | fallStopCount | gyroAbsMax100 | accPitchDevMax100 | balHzAbsMax | kalmanBiasMin1000 | kalmanBiasMax1000 | manualReq1000 | manualApplied1000 | manualI1000 | manualTurnReqHz | positionHoldSuspended | manualNeedsZeroBits | manualAgeMs | P_balanceKp | D_balanceKd | O_balanceAngleOffset
# --- reconnect new session @ 14:38:53 ---
# --- reconnect new session @ 14:38:53 ---
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
