jinxiao123580-hub/balance-car/history/experiments/openocd-legacy/README.md

# 历史OpenOCD诊断脚本说明

| 属性 | 内容 |
| --- | --- |
| 文档编号 | PH-OPENOCD-LEGACY |
| 更新日期 | 2026-10-28，Asia/Shanghai；时分未记录 |

## 适用范围

脚本来源于历史固件版本，部分包含当时的固定RAM/Flash地址，并可能halt控制器。源文件保留用于追溯，未在迁移或文档更新过程中执行。

## 使用条件

仅在依据当前ELF重新确认地址及停机影响后开展诊断。历史脚本存在不表示适用于当前构建，也不作为自动验证项。
