jinxiao123580-hub/balance-car/history/README.md

# 项目历史资料

归档日期：2026-10-28，Asia/Shanghai。本目录收录过往试验与开发过程，当前工程入口位于仓库根README。

| 目录 | 内容 |
| --- | --- |
| reports/ | 开发时间线、阶段报告、勘误与证据索引 |
| data/raw/ | 94份日期命名调参CSV及其他历史诊断数据 |
| versions/ | 16个固件快照、面板旧版及历史维护资料 |
| experiments/ | 独立UART、BLE与旧OpenOCD诊断工程 |
| software/ | 旧面板、绘图和专题分析脚本 |
| media/video/ | 早期演示视频，未作为当前版本演示 |
| presentations/ | 早期项目汇报 |
| administration/ | 迁移和归集验证记录 |

## 阅读入口

- [截至2026-10-28的项目进展](reports/project-progress-through-20261028.md)
- [开发时间线](reports/timeline.md)
- [阶段报告索引](reports/README.md)
- [换向与漂移分析](reports/analysis.md)
- [技术勘误](reports/conflicts.md)
- [来源与证据](reports/sources.md)

历史文件保留原试验条件和时间依据，不作为当前默认参数已经完成验证的证明。所有材料均为可追溯记录，没有因整理而新增实机结论。
