jinxiao123580-hub/balance-car/history/data/README.md

# 实验数据管理说明

| 属性 | 内容 |
| --- | --- |
| 文档编号 | PH-DATA-INDEX |
| 更新日期 | 2026-10-28，Asia/Shanghai；时分未记录 |

## 数据范围

raw目录包含94份日期命名ble_tune_log_*.csv及其他诊断记录。失败录制、表头文件和重连标记文件保留，不作为正常实验数据。

## 时间与量纲

文件名时间表示录制起点，ms表示MCU运行时间。100/1000等字段后缀按对应协议缩放；多版本表头分别解析。分析须区分时间回退、参数变化和人工操作。

## 验证状态

迁移阶段逐文件校验字节，未重算全部数据。既有稳定片段统计见[进展报告](../reports/project-progress-through-20261028.md)，当前分析工具位于software/analysis。面板新录制写入docs/validation/recordings，本目录只保留既有历史数据。
