jinxiao123580-hub/balance-car/history/presentations/README.md

# 项目汇报资料说明

| 属性 | 内容 |
| --- | --- |
| 文档编号 | PH-PRESENTATIONS |
| 更新日期 | 2026-10-28，Asia/Shanghai；时分未记录 |

## 已有资料

平衡车系统汇报.pptx保留早期方案和选型背景，不作为当前固件与电路配置说明。未逐页完成公开发布审查，仅保留在本机并由Git忽略，不包含在公开仓库中。

## 外部资料范围

包含其他研究内容的大型组会汇报留原处，历史报告引用其第183～186页作为早期步进阶段来源，未整份纳入本项目。
