jinxiao123580-hub/balance-car/history/media/video/README.md

# 早期视频资料

本机归档的早期视频尚未逐段完成公开内容审查，且含拍摄设备元数据，暂不上传GitHub。视频不作为当前版本的实车演示。

后续公开演示应核对画面、声音中的个人信息，清除定位及拍摄设备信息，并标明硬件、软件版本与试验日期。
