jinxiao123580-hub/balance-car/history/software/ble-panel/2026-10-30-position-angle/README.md

位置倾角点动阶段面板与回归快照，归档于2026-10-30。后续当前面板改为固定O±2°按住控制；本目录不参与当前启动链。
