jinxiao123580-hub/balance-car/history/versions/imported-history/report_control_history_20260917_20261028.md

# 控制试验历史记录归档摘要

| 属性 | 内容 |
| --- | --- |
| 归档编号 | PH-ARCH-CONTROL-20261028 |
| 主要事件时间 | 2026-09-17～18，含日期未知的早期事项 |
| 原整理日期 | 2026-10-28 |
| 规范化日期 | 2026-10-28，Asia/Shanghai |

## 1. 归档内容

记录涉及IMU迁移、速度方向、频率积分主链、高速保护、四子步平滑、遥测字段错配和细分位序。封面整理日期不是所有事件的发生日期。

## 2. 统一记录位置

详细阶段内容见[控制与遥测联调报告](../../reports/records/report_control_20260917_20260918.md)。早期材料未覆盖TMC集成，不据此判定整个项目未使用TMC。

## 3. 状态

保留已确认现象与未验证假设的区分，原始工作记录存于仓库外中转区。当前软件状态以主工程及后续集成报告为准。
