jinxiao123580-hub/balance-car/(commit log)

2026-10-28 Publish STM32 balance car firmware, hardware and project documentation
    [_bt_probe.csv, _bt_probe2.csv, _diag.csv, _diag2.csv, _vertical_probe.csv, ble_diag_log.csv, ble_linktest.csv, ble_tune_log.csv]
2026-11-03 Document MS42C motor, encoder and power baseline; add third-party notice
2026-11-03 Publish 2026-10-29..31 validation data, analysis and design notes
    [ble_tune_log_20261029_094543_101_p1052.csv, ble_tune_log_20261029_095731_224_p22200.csv, ble_tune_log_20261029_143827_401_p32036.csv, ble_tune_log_20261029_144143_250_p32036.csv, ble_tune_log_20261029_145719_771_p29480.csv, ble_tune_log_20261029_182546_662_p28652.csv, ble_tune_log_20261029_192832_856_p13304.csv, ble_tune_log_20261029_193502_502_p27916.csv]
2026-11-04 Correct STEP timer assignment to TIM2/TIM5 in MCU pin notes
